jazari-akuna/lib-elec/3D/Board/NodeMCU Esp32/Src/esp32_dev_kit_v1_asm.stp

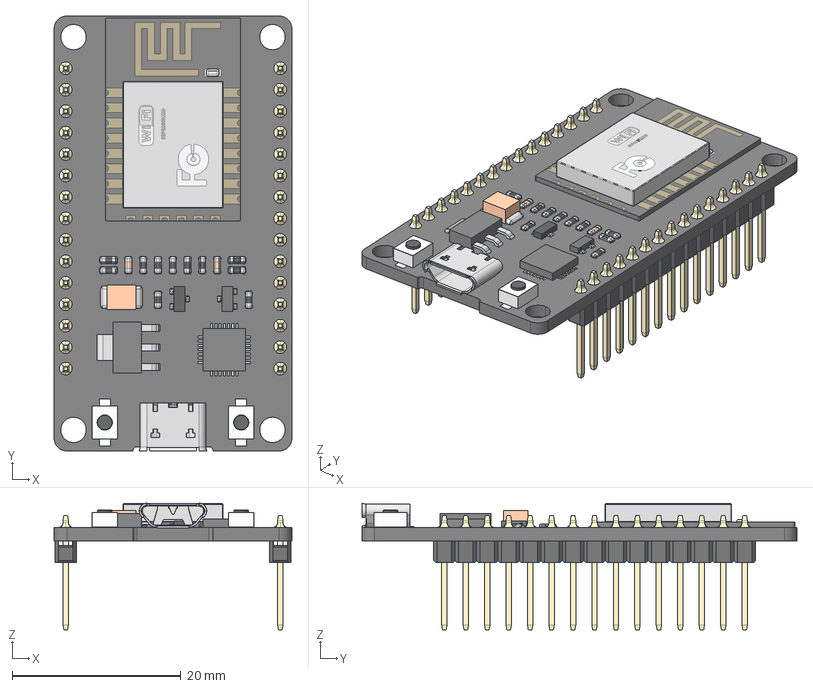
[picture p1: CAD file, 2024-03-29]
3D/Board/NodeMCU Esp32/Src/esp32_dev_kit_v1_asm.stp
28.1 x 51.5 x 15.0 mm
PCB
PIN x 30
WIFI_CARD_2
RECTANGULARCHIP_2
MICROCHIP_2
TANCHIP_2
TRANSISTOR_3-LEG_2
RESISTOR1_2 x 11
RESISTOR2-32_2 x 2
TRANSISTOR_3-LEG2_2
BUTTONFLASH-13_2 x 2
BUTTONFLASH-14_2 x 2
USB_SOCKET_2
