jazari-akuna/lib-elec/3D/Board/Adafruit BMP390/Adafruit BMP390 THT.stp

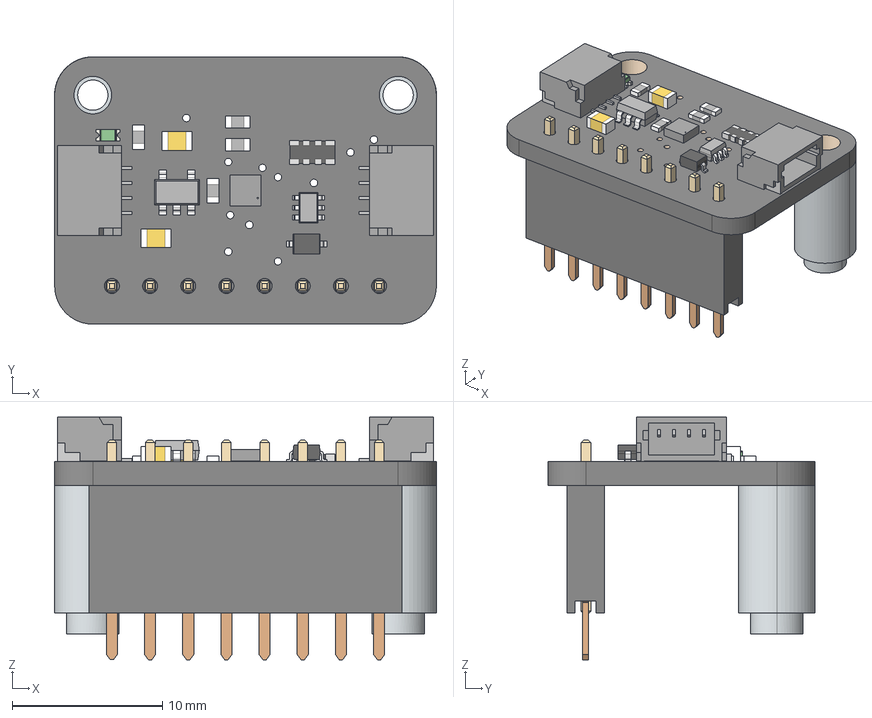
[picture p2: CAD file, 2024-08-19]
3D/Board/Adafruit BMP390/Adafruit BMP390 THT.stp
25.4 x 17.8 x 16.1 mm
Board
10K x 4
1N4148
BMP388
10uF x 2
AP2112K-3.3
10K_1
BSS138
STEMMA_I2C_QT x 2
GREEN
6130xx11821_PIN x 8
