jazari-akuna/lib-elec/3D/Board/Adafruit BNO085/Adafruit BNO085 with SMD Spacers.stp

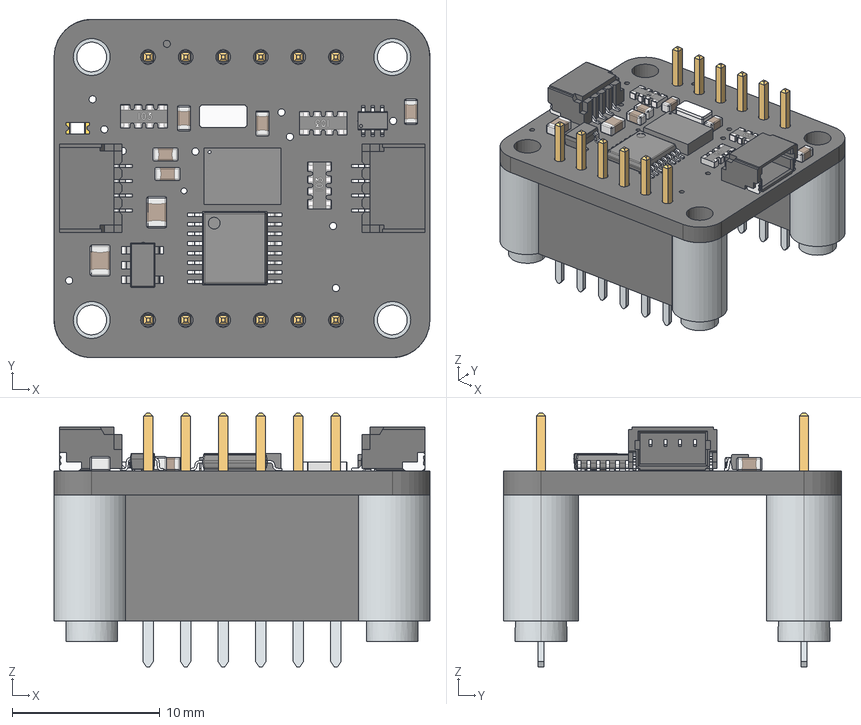
[picture p3: CAD file, 2024-08-19]
3D/Board/Adafruit BNO085/Adafruit BNO085 with SMD Spacers.stp
25.4 x 22.9 x 17.1 mm
Printed Circuit Board
BNO085-9axis-IMU
BODY-TSSOP
LEAD-TSSOP x 16
Crystal_XTAL3215_32.768KHz
SOT23-5
BSS138PS
LED 0603 single color
CAPC-0805-T0.95-BN x 2
CAPC-0603-T0.9-BN x 5
YC164_RESPACK x 3
qwicc x 2
6130xx11121_PIN x 12
6130xx11821_PIN x 12
