jazari-akuna/lib-elec/3D/Board/Adafruit BNO085/Src/Adafruit BNO085 STEMMA QT.step

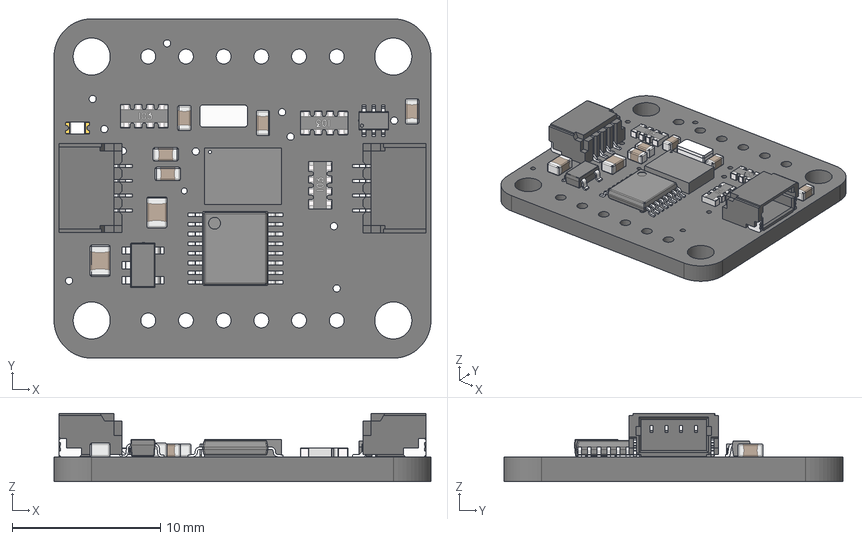
[picture p4: CAD file, 2023-10-14]
3D/Board/Adafruit BNO085/Src/Adafruit BNO085 STEMMA QT.step
25.4 x 22.9 x 4.60 mm
Printed Circuit Board
BNO055-9axis-IMU
BNO085-9axis-IMU
BODY-TSSOP
LEAD-TSSOP x 16
Crystal_XTAL3215_32.768KHz
SOT23-5
BSS138PS
LED 0603 single color
CAPC-0805-T0.95-BN x 2
CAPC-0603-T0.9-BN x 5
YC164_RESPACK x 3
qwicc x 2
