jazari-akuna/lib-elec/3D/Board/Adafruit SD Breakout/Adafruit SD Breakout.stp

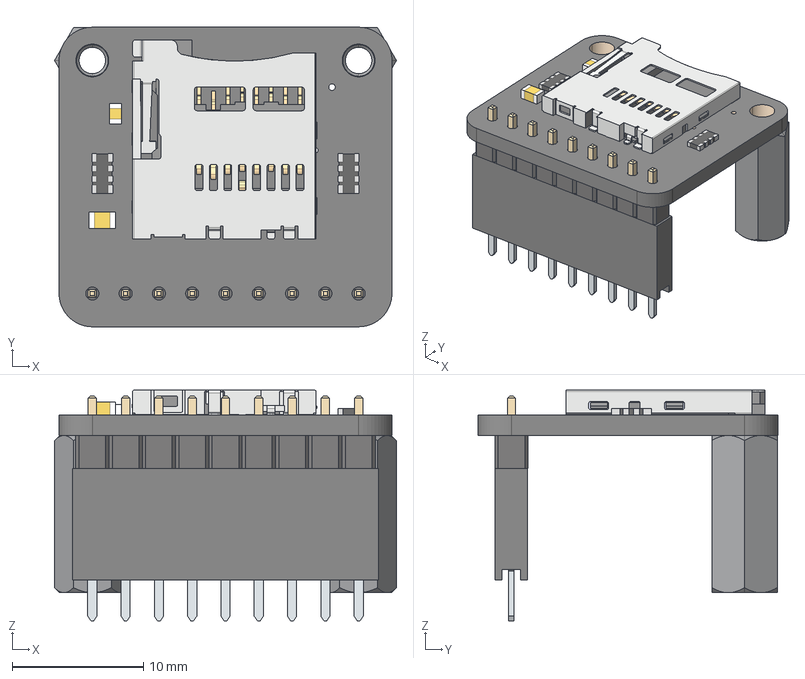
[picture p5: CAD file, 2024-08-19]
3D/Board/Adafruit SD Breakout/Adafruit SD Breakout.stp
26.1 x 22.9 x 17.6 mm
Board.1
microSD
10uF.3
0.1uF
47K x 2
6130xx11821_PIN x 9
