jazari-akuna/lib-elec/3D/Board/Arduino NanoV3 + Female Headers.step

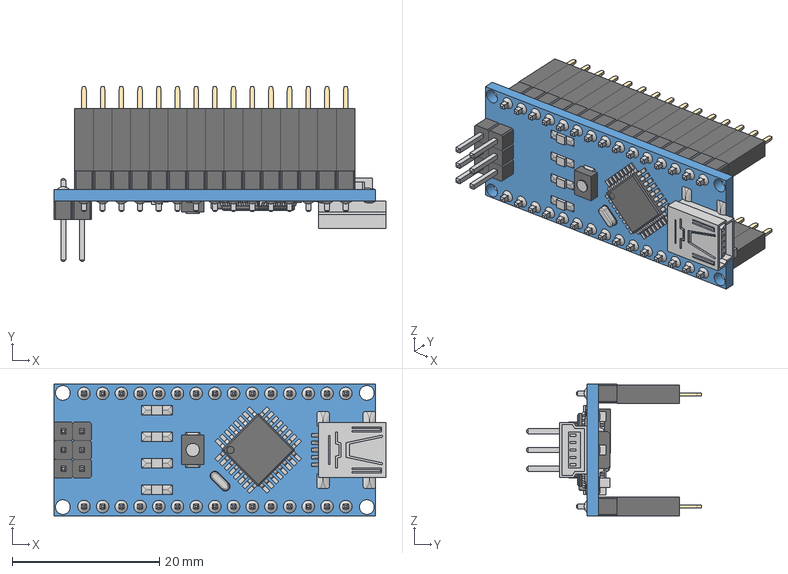
[picture p6: CAD file, 2022-04-12]
3D/Board/Arduino NanoV3 + Female Headers.step
45.1 x 23.7 x 17.9 mm
switch
Led x 3
Led (1)
Pin x 21
chip1
USB
Crystal
Pin (1) x 15
Res x 5
cap x 2
Chip
respack x 2
diode
vreg
HF1 x 30
