jazari-akuna/lib-elec/3D/Board/NodeMCU Esp32/NodeMCU Esp32.stp

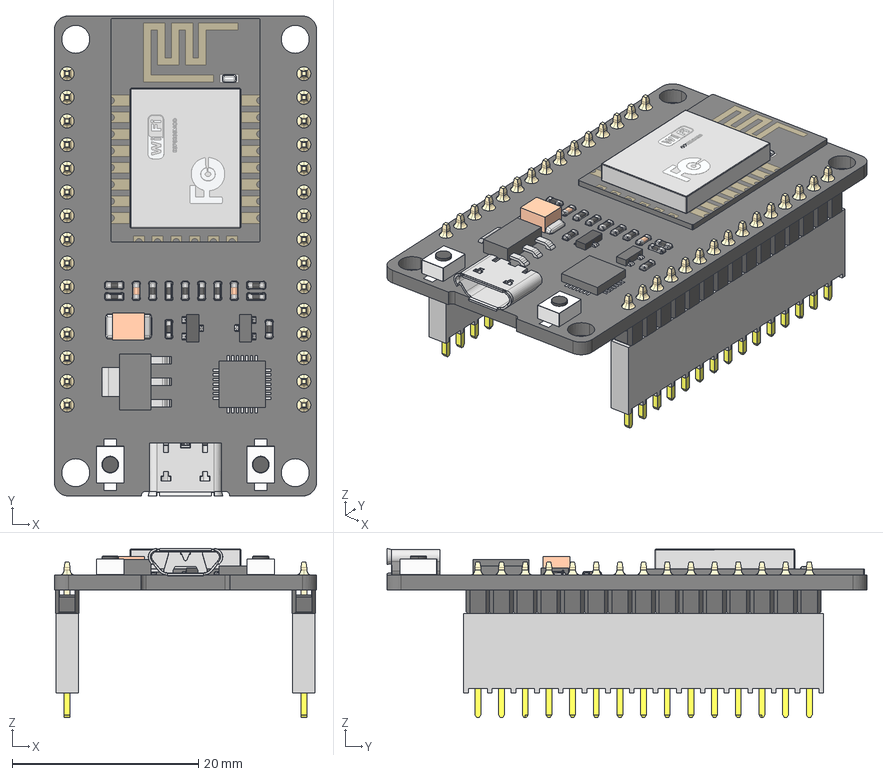
[picture p7: CAD file, 2024-03-29]
3D/Board/NodeMCU Esp32/NodeMCU Esp32.stp
28.1 x 51.5 x 18.2 mm
PCB
PIN x 30
WIFI_CARD_2
RECTANGULARCHIP_2
MICROCHIP_2
TANCHIP_2
TRANSISTOR_3-LEG_2
RESISTOR1_2 x 11
RESISTOR2-32_2 x 2
TRANSISTOR_3-LEG2_2
BUTTONFLASH-13_2 x 2
BUTTONFLASH-14_2 x 2
USB_SOCKET_2
_T1SSQ-115-01-G-S x 2
_P2SSQ-115-01-G-S x 2
