jazari-akuna/lib-elec/3D/Board/Nucleo F411RE/Src/Download_STEP_970110155 (rev1).stp

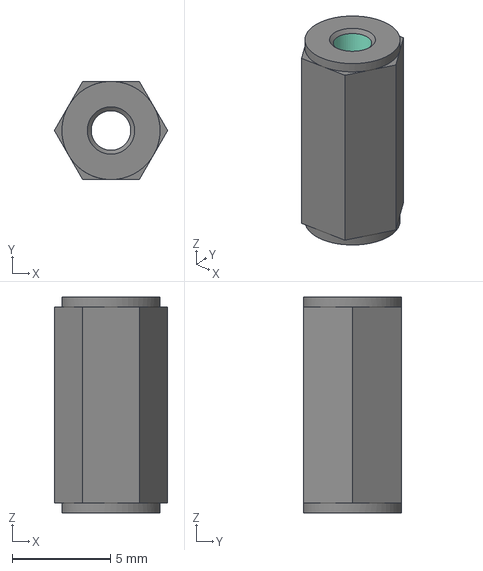
[picture p9: CAD file, 2021-08-15]
3D/Board/Nucleo F411RE/Src/Download_STEP_970110155 (rev1).stp
5.77 x 5.00 x 11.0 mm
