jazari-akuna/lib-elec/3D/Board/Nucleo F411RE/Src/Pin Header 2 x 19 2.54mm/38-Pin Header - Female - Double - 2.54mm.step

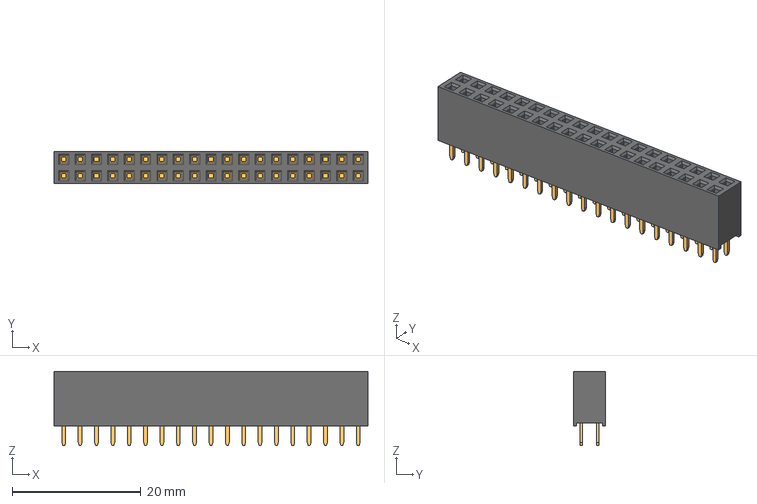
[picture p10: CAD file, 2021-11-29]
3D/Board/Nucleo F411RE/Src/Pin Header 2 x 19 2.54mm/38-Pin Header - Female - Double - 2.54mm.step
48.8 x 5.00 x 11.5 mm
