jazari-akuna/lib-elec/3D/Board/Raspberry Pi 4b/Src/Download_STEP_970180155 (rev1).stp

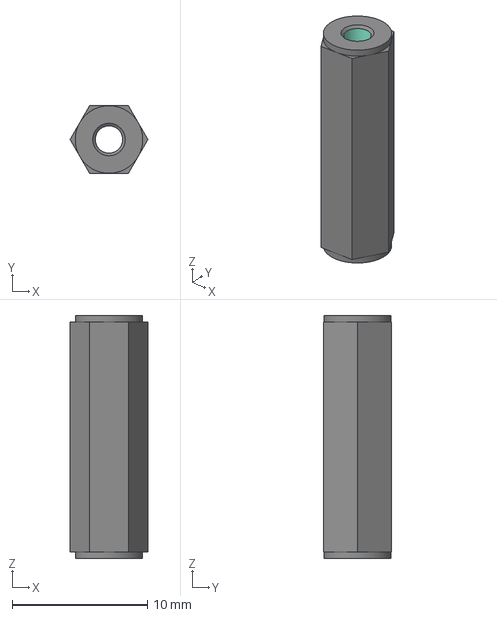
[picture p11: CAD file, 2021-08-15]
3D/Board/Raspberry Pi 4b/Src/Download_STEP_970180155 (rev1).stp
5.77 x 5.00 x 18.0 mm
