jazari-akuna/lib-elec/3D/Board/Raspberry Pi 4b/Src/ESQ-120-24-T-D/ESQ-120-24-T-D.stp

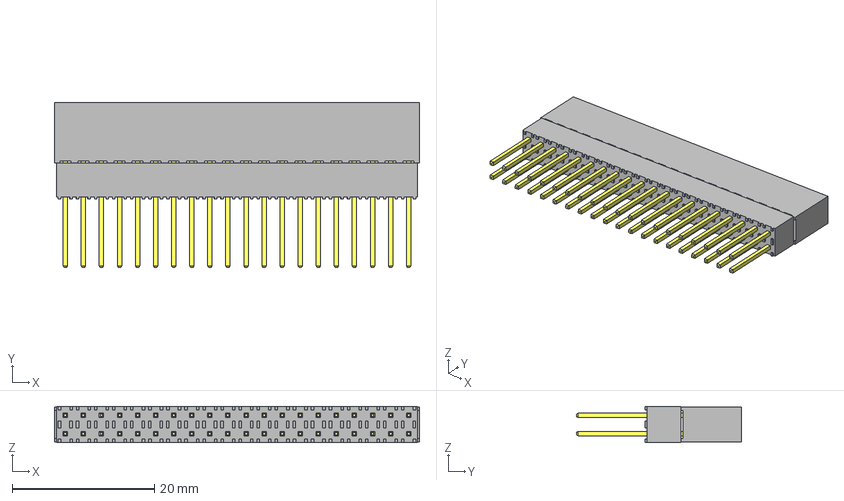
[picture p12: CAD file, 2021-01-02]
3D/Board/Raspberry Pi 4b/Src/ESQ-120-24-T-D/ESQ-120-24-T-D.stp
51.3 x 23.2 x 5.08 mm
_ESQ-120-24-T-D_socket
_ESQ-120-24-T-D_pins
_ESQ-120-24-G-D-LL_bpins
