jazari-akuna/lib-elec/3D/Board/Raspberry Pi Zero W/Src/microsd-card.stp

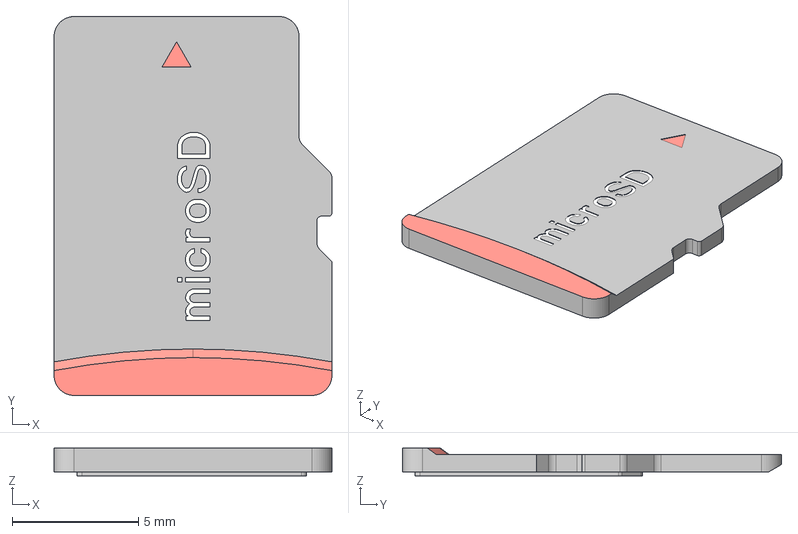
[picture p13: CAD file, 2024-03-23]
3D/Board/Raspberry Pi Zero W/Src/microsd-card.stp
11.0 x 15.0 x 1.10 mm
