jazari-akuna/lib-elec/3D/Components/Download_STEP_150302xx73100 (rev1).stp

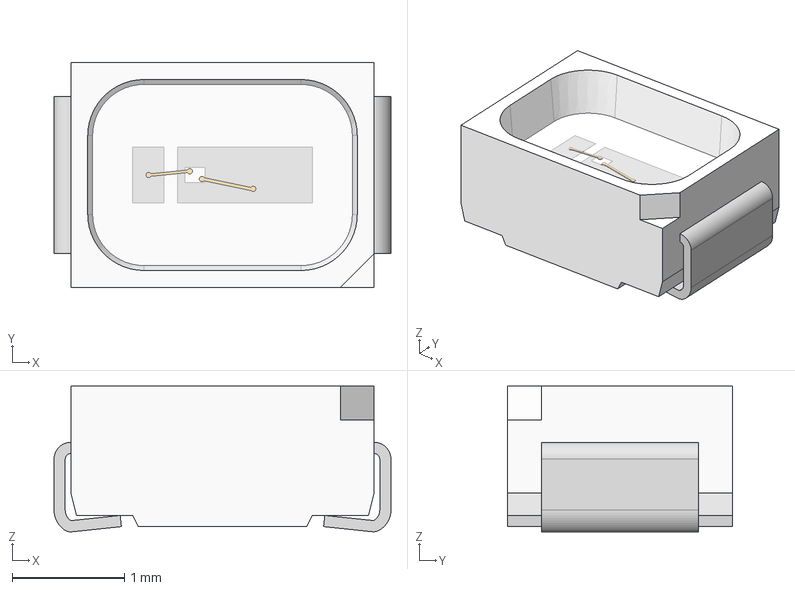
[picture p14: CAD file, 2025-03-05]
3D/Components/Download_STEP_150302xx73100 (rev1).stp
3.00 x 2.00 x 1.30 mm
Glue
Pin
