jazari-akuna/lib-elec/3D/Components/ESC/Download_STP_61300611121 (rev1).stp

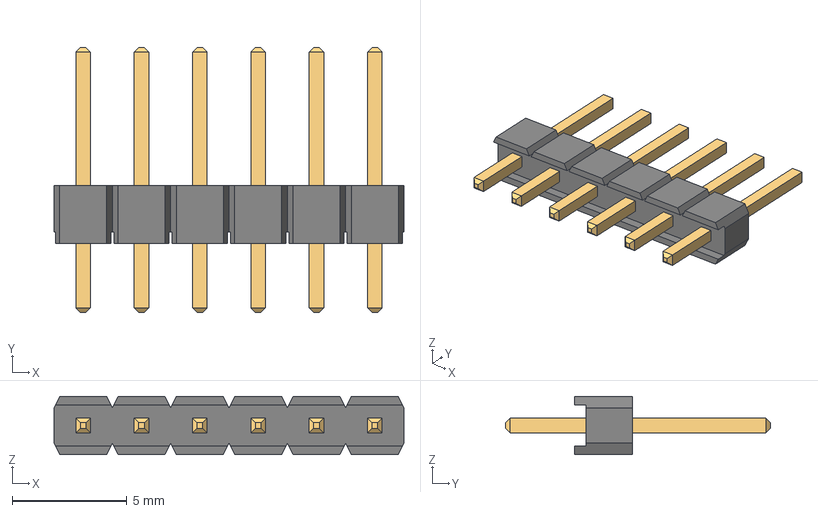
[picture p15: CAD file, 2023-07-14]
3D/Components/ESC/Download_STP_61300611121 (rev1).stp
15.2 x 11.5 x 2.54 mm
6130xx11121_PIN x 6
