jazari-akuna/lib-elec/3D/Components/MP1584EN/Download_STP_61300211121 (rev1).stp

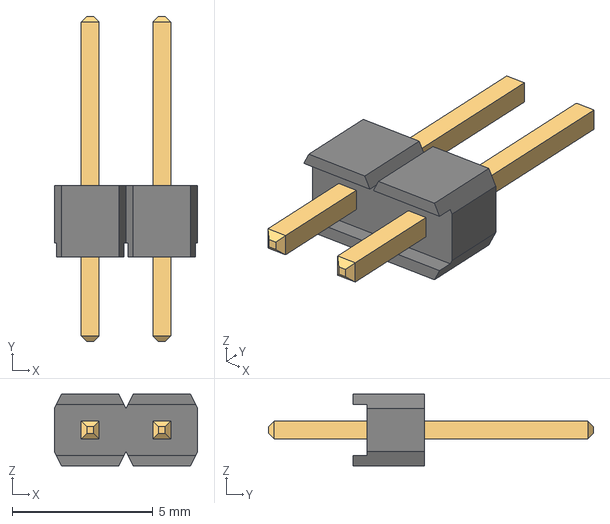
[picture p16: CAD file, 2022-04-12]
3D/Components/MP1584EN/Download_STP_61300211121 (rev1).stp
5.08 x 11.5 x 2.54 mm
6130xx11121_PIN x 2
