jazari-akuna/lib-elec/3D/Connectors/Download_STP_686108188622 (rev1).stp

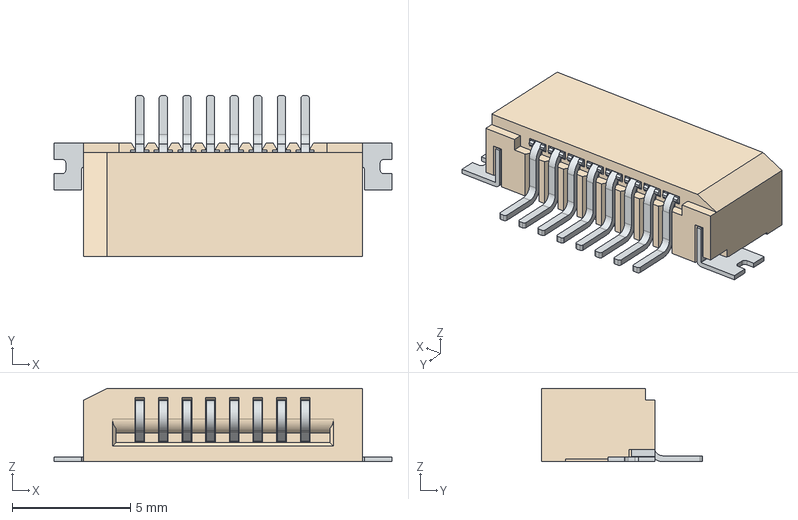
[picture p17: CAD file, 2025-01-11]
3D/Connectors/Download_STP_686108188622 (rev1).stp
14.3 x 6.80 x 3.11 mm
6861xx188622_Pin x 8
6861xx188622_PadGh
6861xx188622_PadDt
