jazari-akuna/lib-elec/3D/Pad Silicone 6x2mm.stp

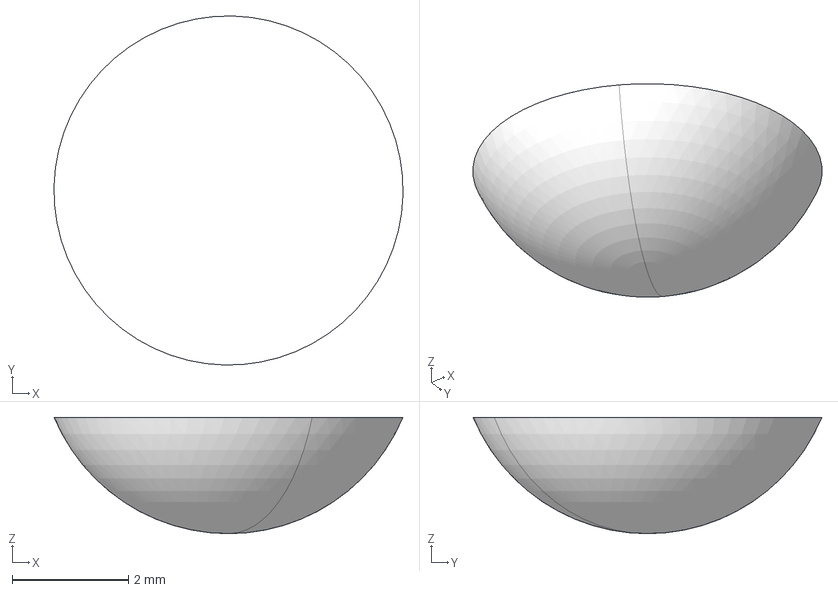
[picture p18: CAD file, 2023-09-23]
3D/Pad Silicone 6x2mm.stp
6.00 x 6.00 x 2.00 mm
