jazari-akuna/lib-elec/3D/Board/Nucleo F303K8/MB1180-with-connector.stp

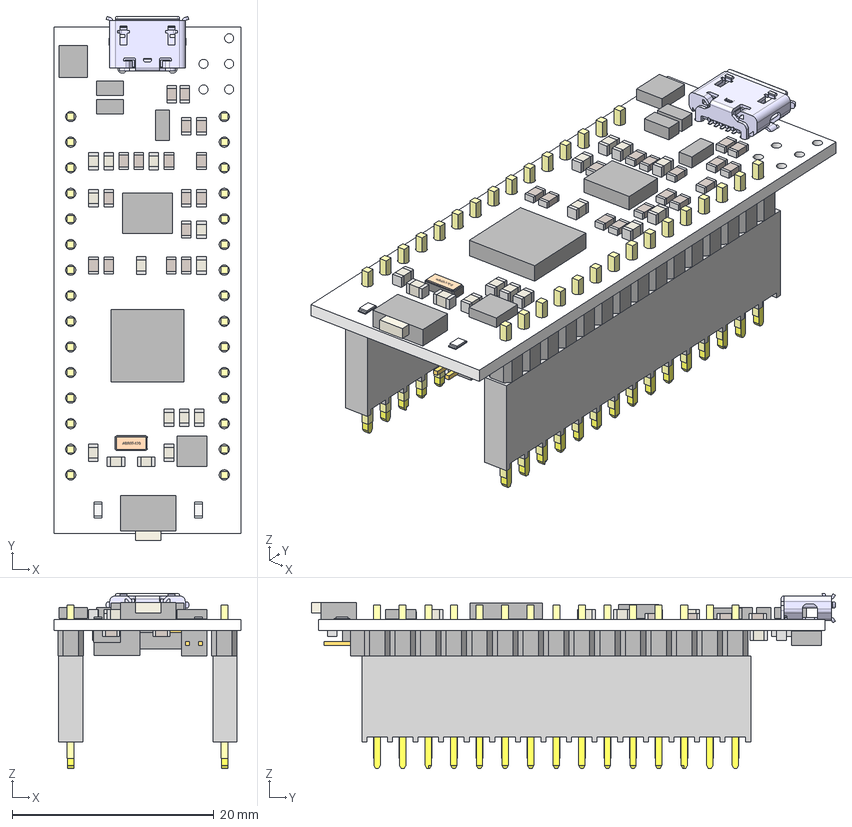
[picture p20: CAD file, 2020-11-15]
3D/Board/Nucleo F303K8/MB1180-with-connector.stp
18.5 x 52.0 x 17.4 mm
Extruded x 2
Extruded_1
Extruded_2
Extruded_3
Extruded_4 x 2
Extruded_5
Extruded_6
Extruded_7
Extruded_8 x 40
Extruded_9 x 20
Extruded_10 x 2
Extruded_11
ABS07-120
Extruded_12
Extruded_13
Extruded_14
Extruded_15
Extruded_16 x 34
Extruded_17 x 17
Extruded_18 x 12
Extruded_19 x 6
Extruded_20 x 2
Extruded_21
Extruded_22 x 2
Extruded_23
Extruded_24
Extruded_25
Extruded_26 x 2
Extruded_27 x 2
Extruded_28
Extruded_29 x 6
Extruded_30 x 3
Extruded_31 x 30
Extruded_32 x 30
Extruded_33
Extruded_34
Extruded_35
Extruded_36
_T1SSQ-115-01-G-S x 2
_P2SSQ-115-01-G-S x 2
