jazari-akuna/lib-elec/3D/Components/ESC/CtrlBL_Emax_Bullet_Pro_35A.STEP

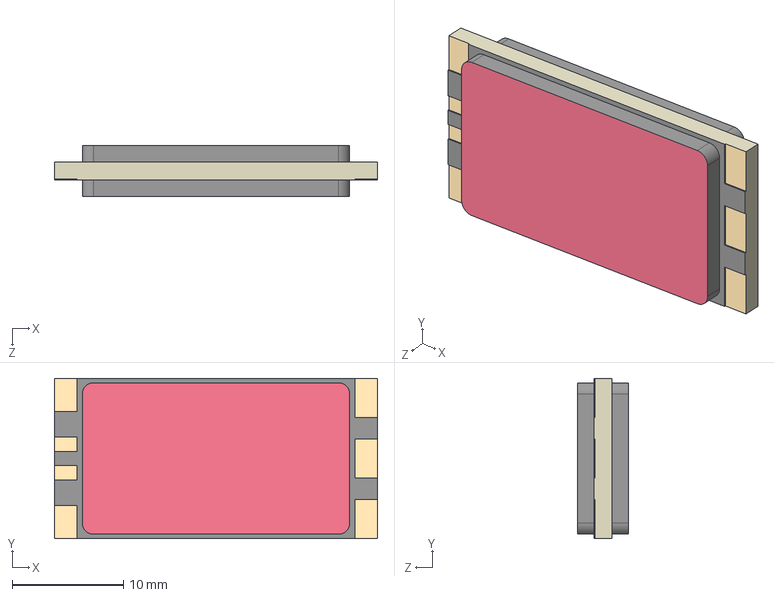
[picture p22: CAD file, 2023-07-14]
3D/Components/ESC/CtrlBL_Emax_Bullet_Pro_35A.STEP
29.0 x 14.4 x 4.60 mm
