jazari-akuna/lib-elec/3D/Components/GC9A01/GC9A01.stp

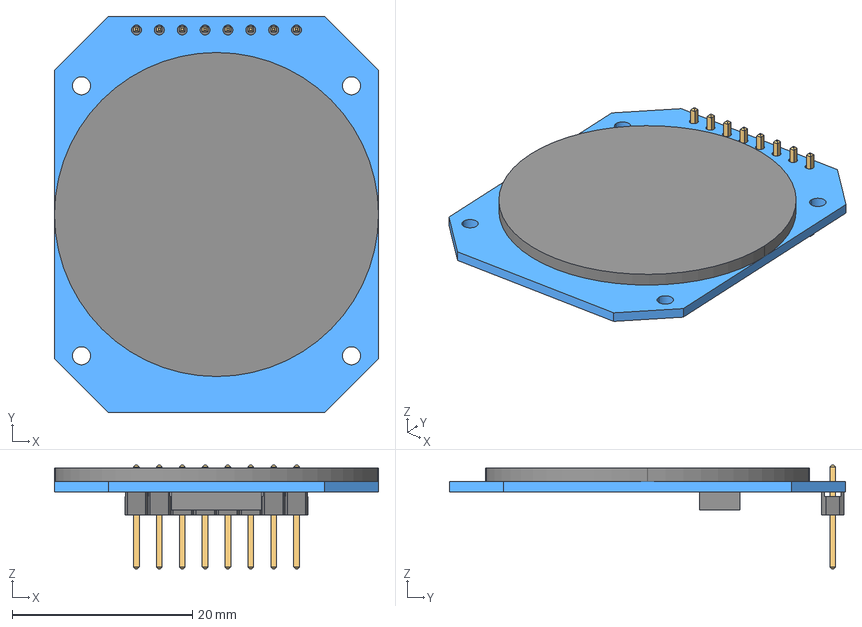
[picture p23: CAD file, 2023-07-14]
3D/Components/GC9A01/GC9A01.stp
36.0 x 44.0 x 11.5 mm
GC9A01.1
6130xx11121_PIN x 8
