jazari-akuna/lib-elec/3D/Components/KS33-low profile switch and stabilzier.stp

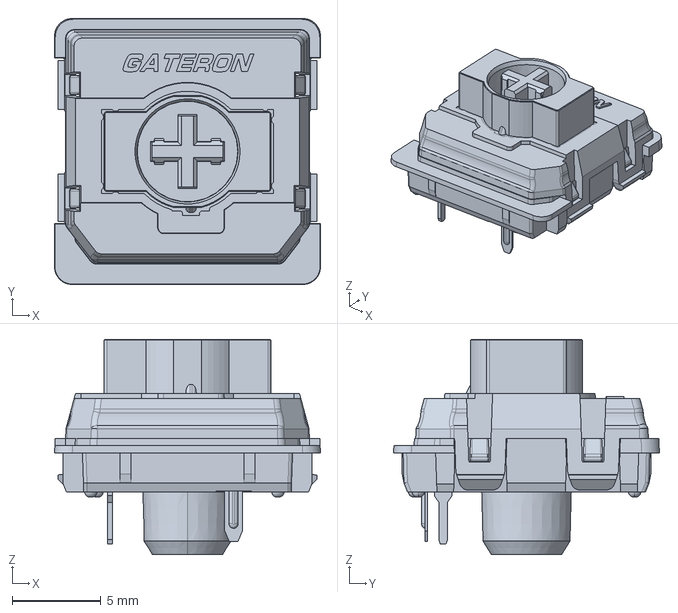
[picture p24: CAD file, 2025-03-05]
3D/Components/KS33-low profile switch and stabilzier.stp
15.0 x 15.0 x 12.1 mm
