jazari-akuna/lib-elec/3D/Connectors/Download_STEP_693071020811 (rev1).stp

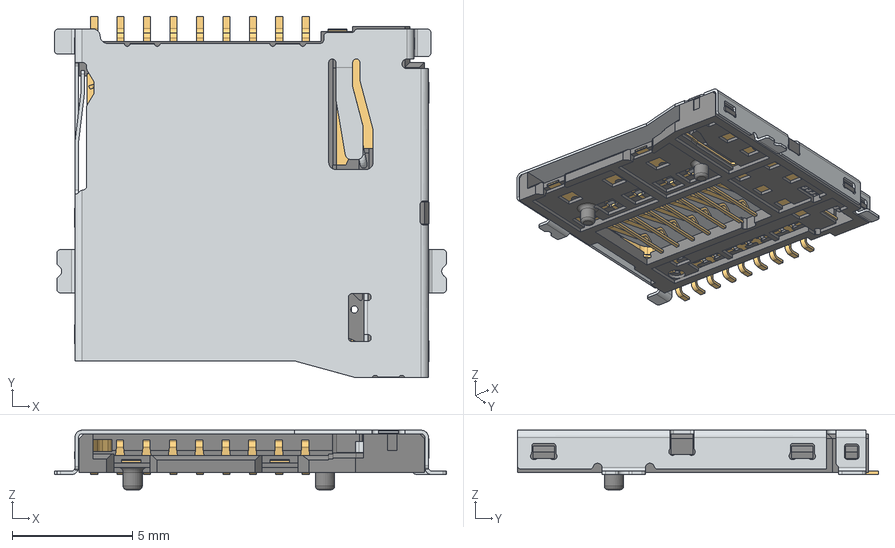
[picture p25: CAD file, 2024-11-05]
3D/Connectors/Download_STEP_693071020811 (rev1).stp
16.3 x 15.0 x 2.48 mm
693071020811_Housing
693071020811_Guide
693071020811_Spring
693071020811_Contact
693071020811_Hook
693071020811_Agraphe
693071020811_Shielding
