jazari-akuna/lib-elec/3D/Board/Nucleo F303K8/Src/SSQ-115-01-G-S.stp

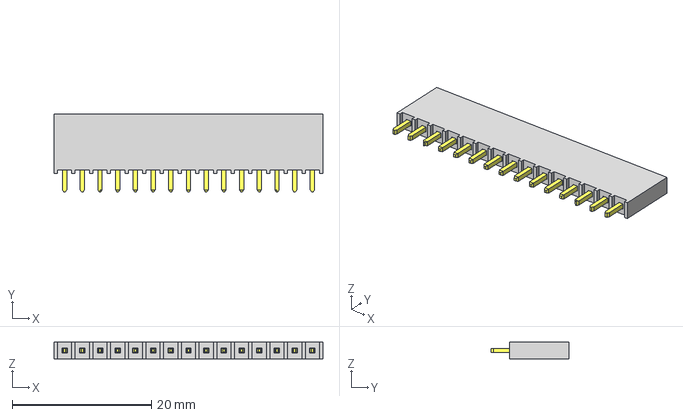
[picture p26: CAD file, 2020-11-15]
3D/Board/Nucleo F303K8/Src/SSQ-115-01-G-S.stp
38.6 x 11.2 x 2.41 mm
_T1SSQ-115-01-G-S
_P2SSQ-115-01-G-S
