jazari-akuna/lib-elec/3D/Components/Download_STP_830009678 (rev1).stp

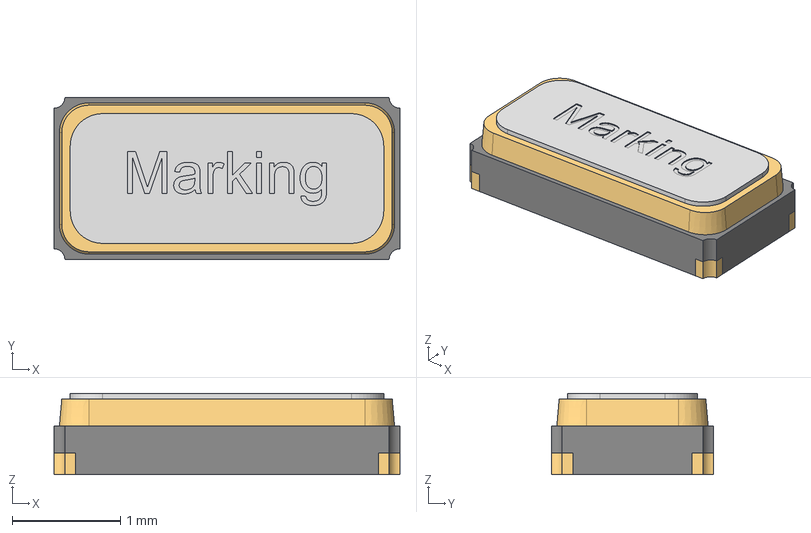
[picture p27: CAD file, 2025-02-01]
3D/Components/Download_STP_830009678 (rev1).stp
3.20 x 1.50 x 0.75 mm
Pins
Cover
