jazari-akuna/lib-elec/3D/Components/ESC/ESC_Emax_Bullet_15A.stp

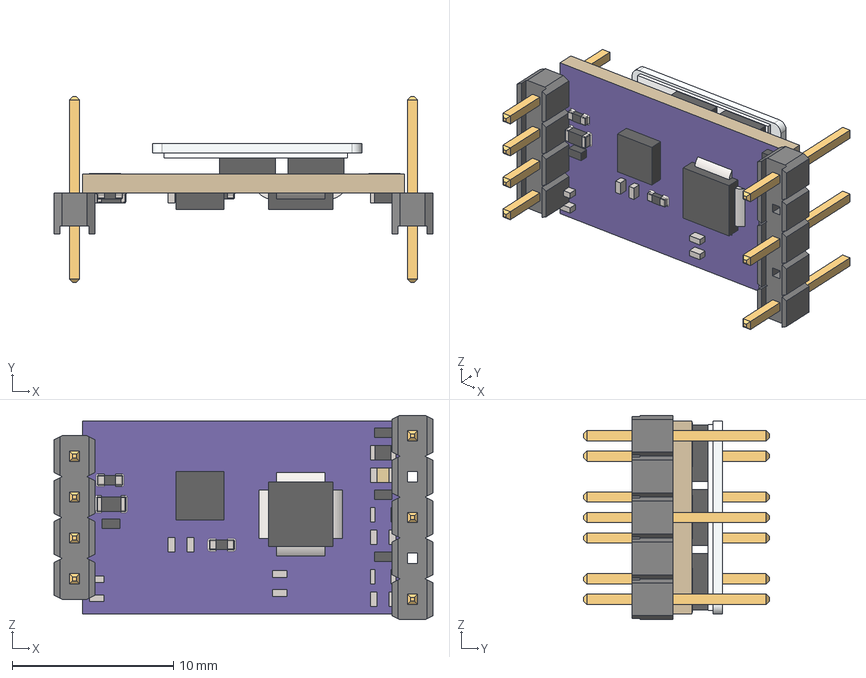
[picture p28: CAD file, 2023-07-14]
3D/Components/ESC/ESC_Emax_Bullet_15A.stp
23.5 x 11.5 x 12.7 mm
CtrlBL_Emax_Bullet_15A_light
6130xx11121_PIN x 4
6130xx11121_PIN.2 x 3
