jazari-akuna/lib-elec/3D/Components/GC9A01/GC9A01-LowProfile.stp

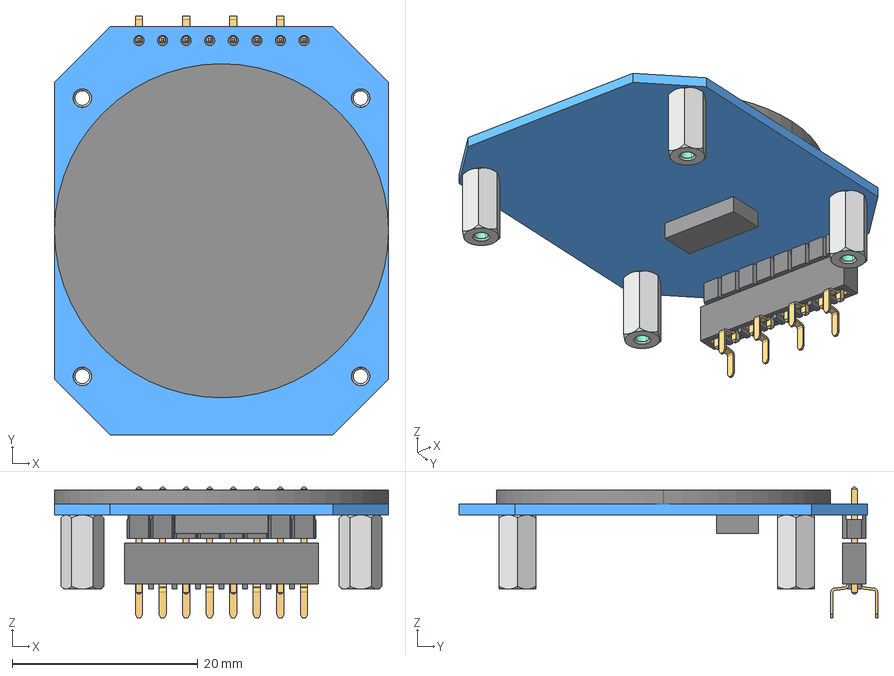
[picture p29: CAD file, 2023-07-14]
3D/Components/GC9A01/GC9A01-LowProfile.stp
36.0 x 45.1 x 14.1 mm
GC9A01.1
6130xx11121_PIN x 8
6130xx15721_PIN x 8
