jazari-akuna/lib-elec/3D/Components/Downloads_STP_WL-OSEN_1642730961200 (rev1).stp

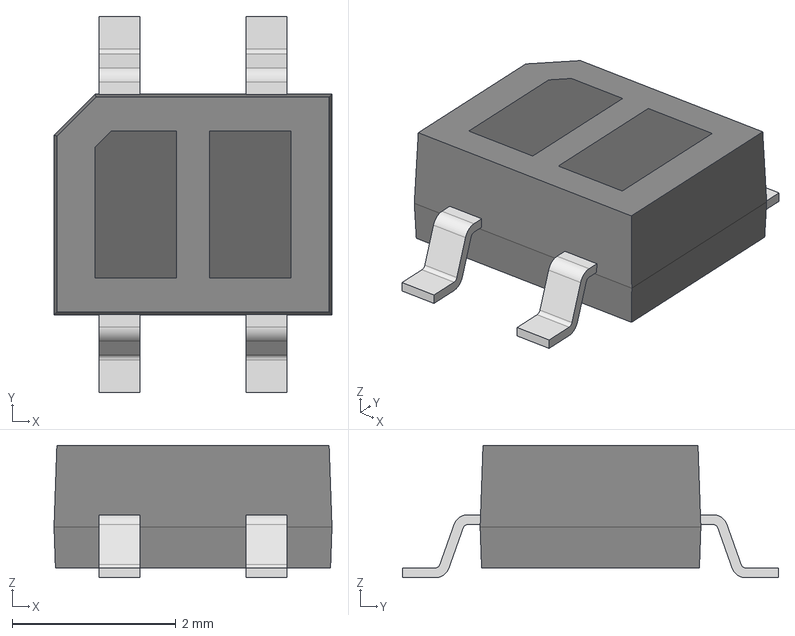
[picture p30: CAD file, 2025-01-11]
3D/Components/Downloads_STP_WL-OSEN_1642730961200 (rev1).stp
3.40 x 4.60 x 1.62 mm
Dome
Pins
