jazari-akuna/lib-elec/3D/Components/ESC/CtrlBL_Emax_Bullet_15A_light.STEP

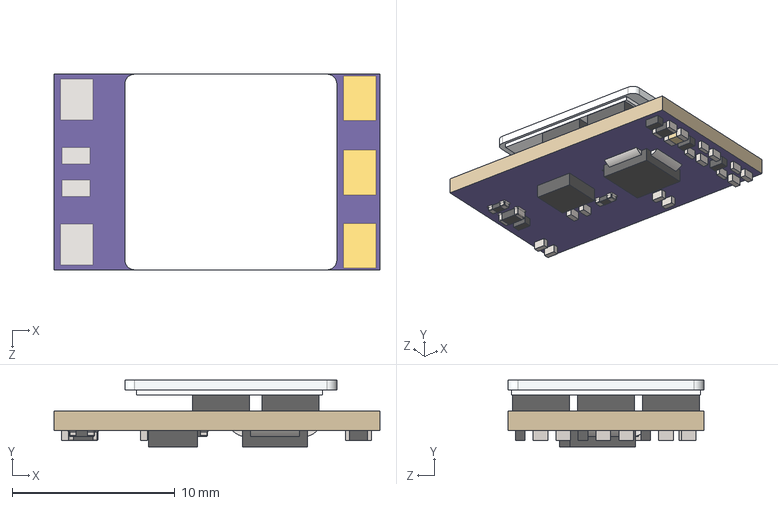
[picture p31: CAD file, 2023-07-14]
3D/Components/ESC/CtrlBL_Emax_Bullet_15A_light.STEP
20.0 x 4.10 x 12.0 mm
