jazari-akuna/lib-elec/3D/Components/GC9A01/Download_STEP_970080244 (rev1).stp

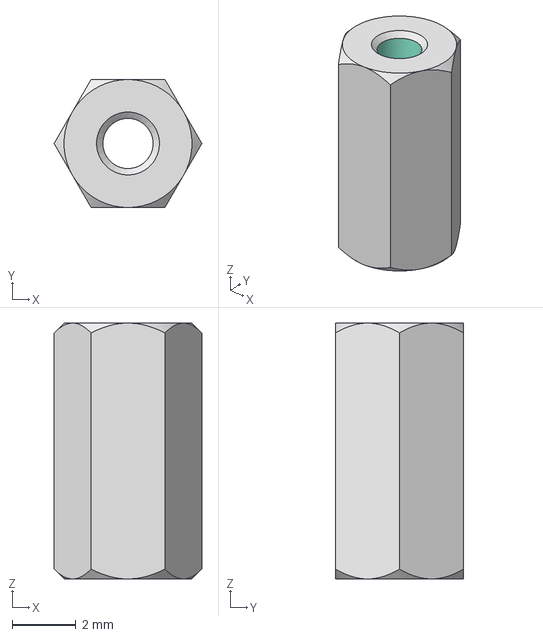
[picture p32: CAD file, 2023-07-14]
3D/Components/GC9A01/Download_STEP_970080244 (rev1).stp
4.62 x 4.00 x 8.00 mm
