jazari-akuna/lib-elec/3D/Connectors/RSP-122811-01--3DModel-STEP-56544.STEP

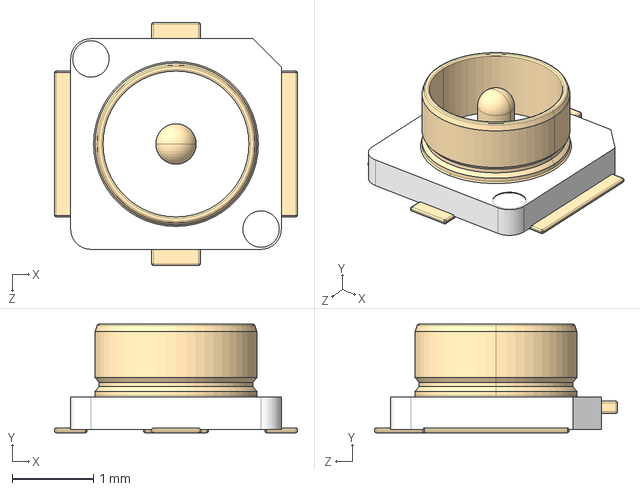
[picture p33: CAD file, 2024-10-28]
3D/Connectors/RSP-122811-01--3DModel-STEP-56544.STEP
3.00 x 1.34 x 3.00 mm
