jazari-akuna/lib-elec/3D/Components/BNO085.stp

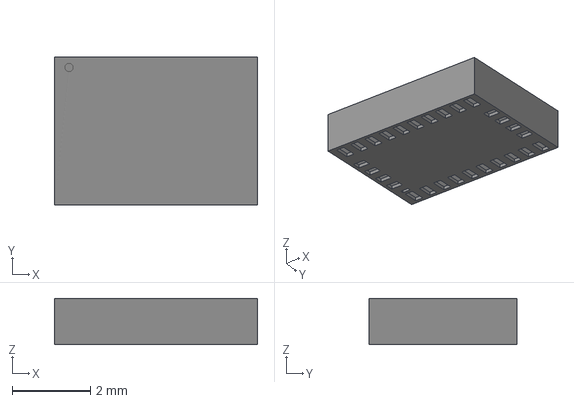
[picture p34: CAD file, 2025-01-02]
3D/Components/BNO085.stp
5.20 x 3.80 x 1.18 mm
