jazari-akuna/lib-elec/3D/Components/ESC/Download_STP_61300411121 (rev1).stp

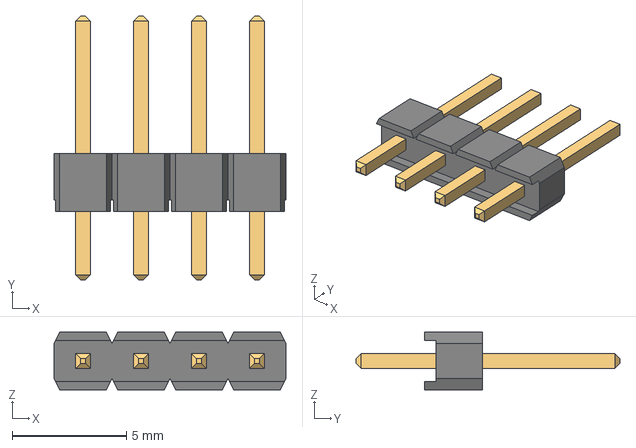
[picture p35: CAD file, 2023-07-14]
3D/Components/ESC/Download_STP_61300411121 (rev1).stp
10.2 x 11.5 x 2.54 mm
6130xx11121_PIN x 4
