jazari-akuna/lib-elec/3D/Connectors/Download_STP_62701420621_rev1.stp

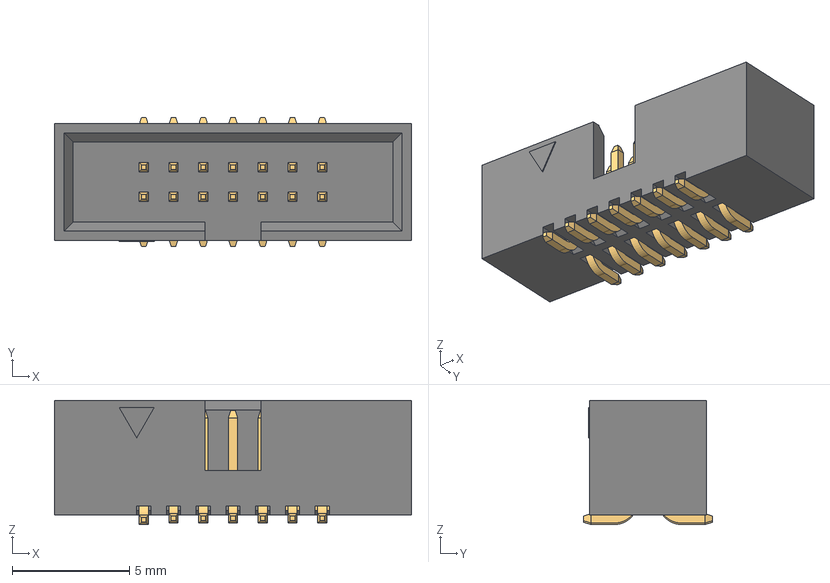
[picture p36: CAD file, 2024-10-28]
3D/Connectors/Download_STP_62701420621_rev1.stp
15.2 x 5.51 x 5.30 mm
6270xx20621_PIN x 14
