jazari-akuna/lib-elec/3D/Components/ESC/ESC_Emax_Bullet_35A.stp

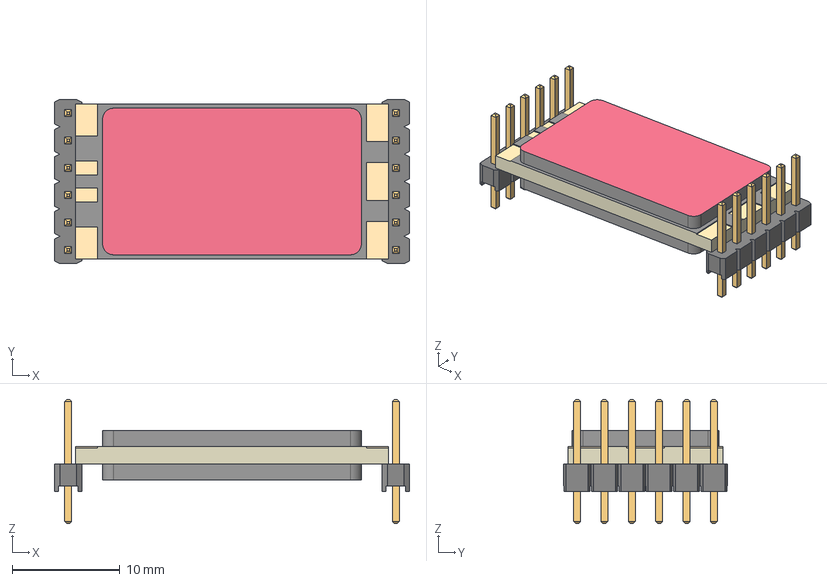
[picture p37: CAD file, 2023-07-14]
3D/Components/ESC/ESC_Emax_Bullet_35A.stp
32.9 x 15.2 x 11.5 mm
CtrlBL_Emax_Bullet_Pro_35A
6130xx11121_PIN x 6
6130xx11121_PIN.2 x 6
