jazari-akuna/lib-elec/3D/Components/PAA5160E1-Q-16L-6x6-LGA.stp

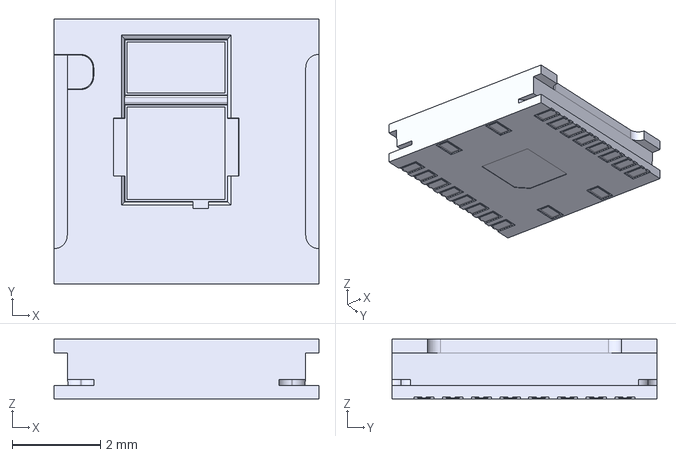
[picture p38: CAD file, 2025-01-02]
3D/Components/PAA5160E1-Q-16L-6x6-LGA.stp
6.00 x 6.00 x 1.35 mm
