jazari-akuna/lib-elec/3D/Components/Download_435441019830_STP (rev1).stp

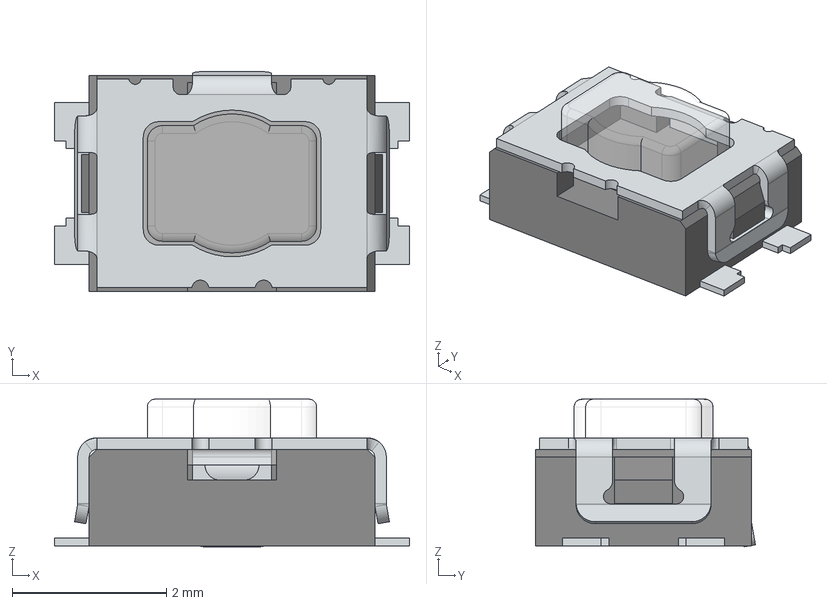
[picture p39: CAD file, 2024-11-05]
3D/Components/Download_435441019830_STP (rev1).stp
4.60 x 2.85 x 1.91 mm
Frame
Cover
Terminal
Button
