jazari-akuna/lib-elec/3D/Components/STP_WL-ICLED_1313210530000 (rev1).stp

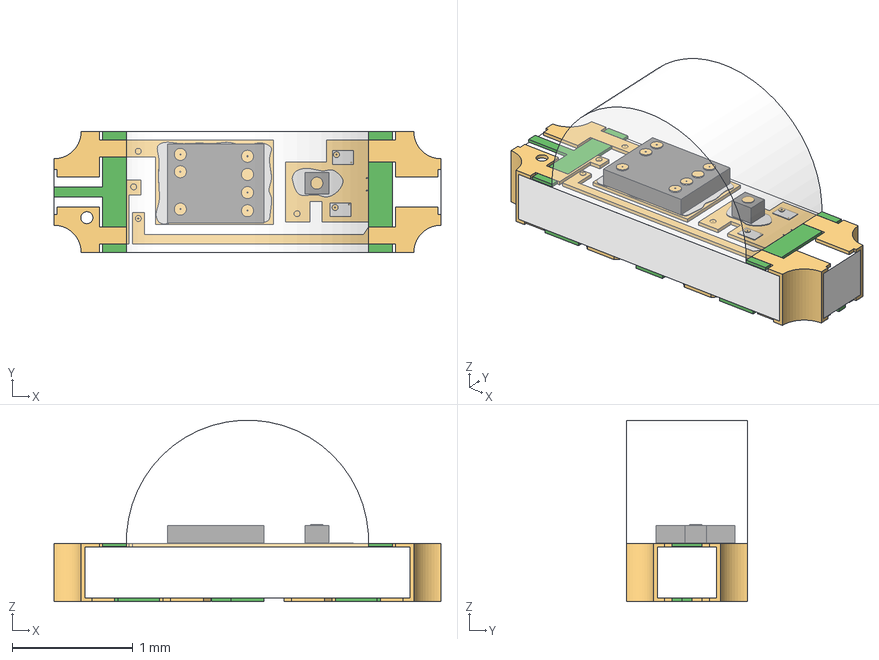
[picture p41: CAD file, 2024-11-05]
3D/Components/STP_WL-ICLED_1313210530000 (rev1).stp
3.20 x 1.00 x 1.50 mm
Contacts
Resin
