jazari-akuna/lib-elec/3D/Connectors/GCT_USB4140-GF-0170-C_REV0.4.stp

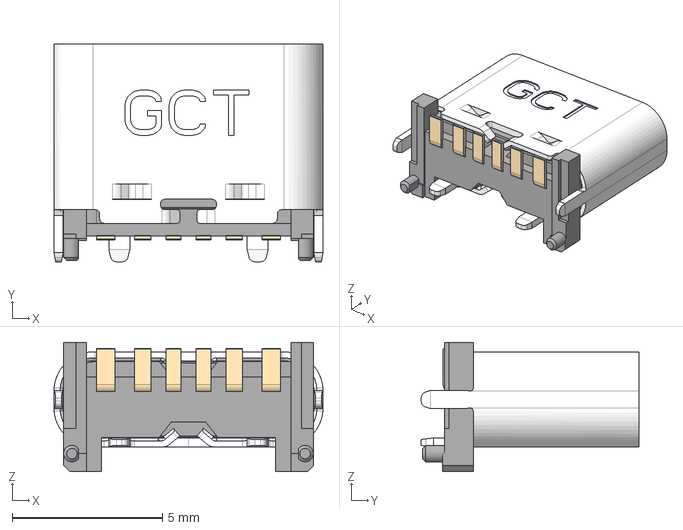
[picture p42: CAD file, 2024-01-22]
3D/Connectors/GCT_USB4140-GF-0170-C_REV0.4.stp
8.94 x 7.23 x 4.30 mm
USB4140-GF-0070-C_PART2
USB4140-GF-0070-C_PART1
