jazari-akuna/lib-elec/3D/Components/STP_74663025 (rev1).stp

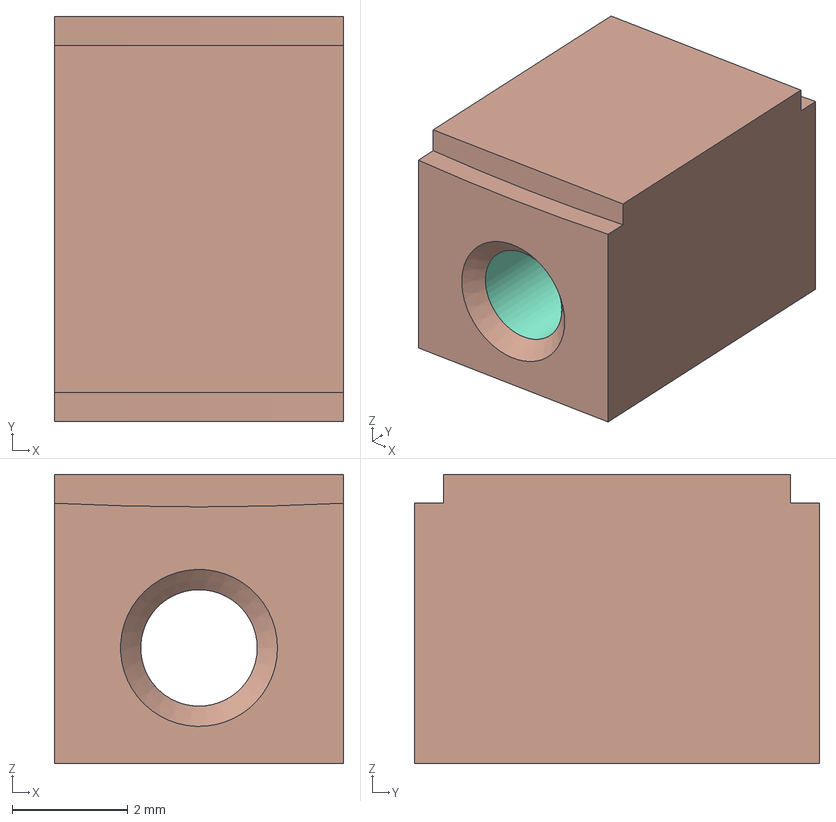
[picture p43: CAD file, 2024-03-09]
3D/Components/STP_74663025 (rev1).stp
5.00 x 7.00 x 5.00 mm
