jazari-akuna/lib-elec/3D/Connectors/STP_MPC5_657003140101 (rev1).stp

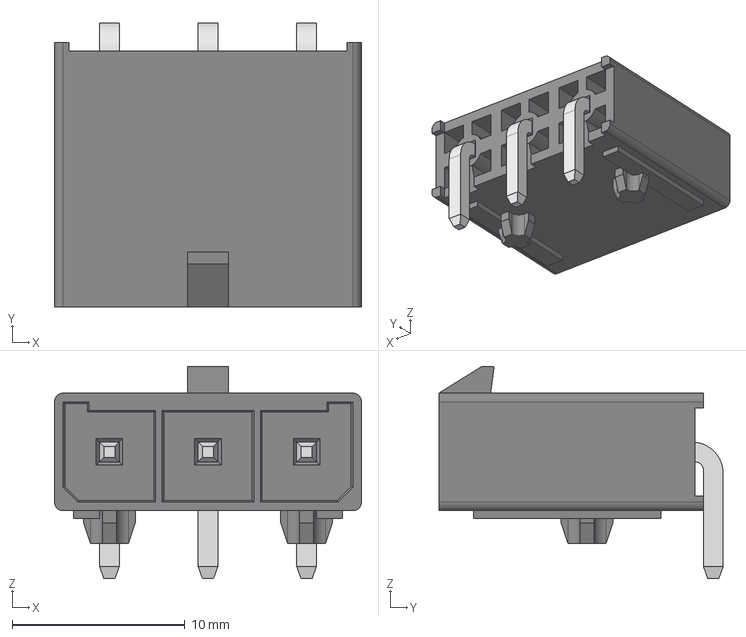
[picture p44: CAD file, 2023-11-17]
3D/Connectors/STP_MPC5_657003140101 (rev1).stp
17.8 x 16.4 x 12.3 mm
6570xx140101_Pin x 3
