jazari-akuna/lib-elec/3D/Connectors/STP_MPC5_657002140101 (rev1).stp

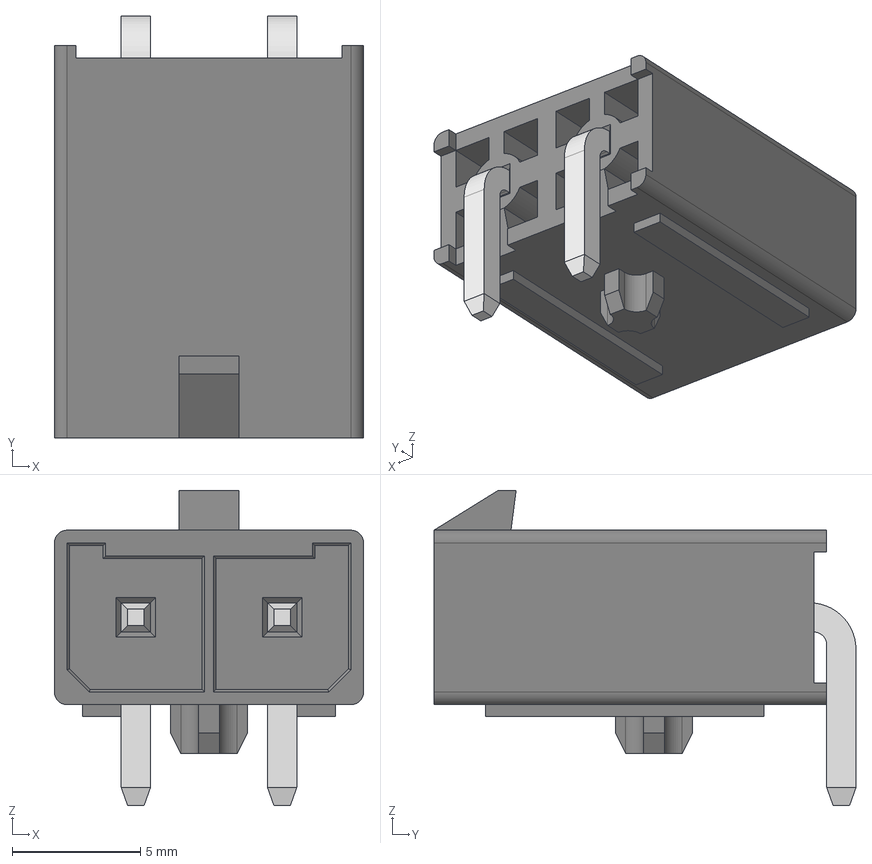
[picture p45: CAD file, 2023-11-17]
3D/Connectors/STP_MPC5_657002140101 (rev1).stp
12.1 x 16.4 x 12.3 mm
6570xx140101_Pin x 2
