jazari-akuna/lib-elec/3D/Components/Download_STP_WL-SBCW-1210 (rev1).stp

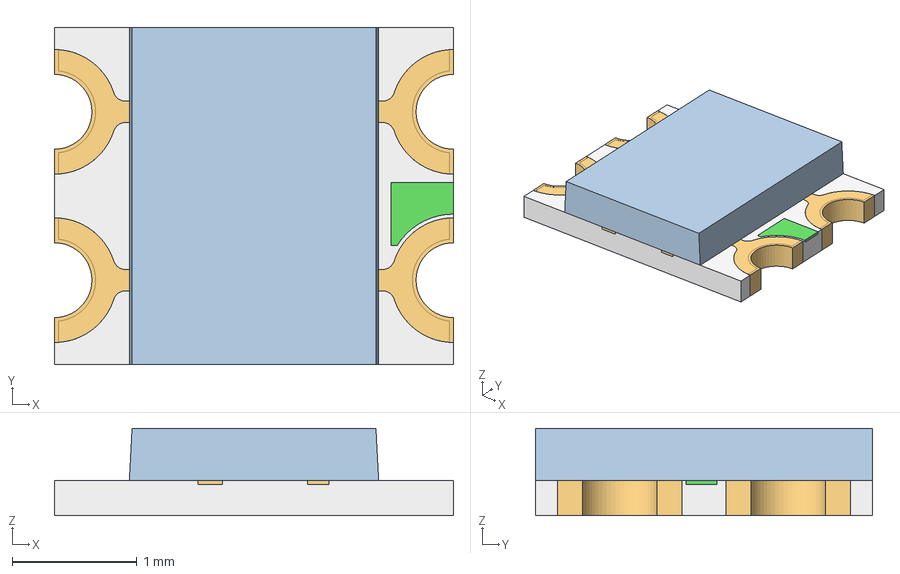
[picture p46: CAD file, 2023-12-19]
3D/Components/Download_STP_WL-SBCW-1210 (rev1).stp
3.20 x 2.70 x 0.7 mm
pole x 2
contact x 4
lense
