jazari-akuna/lib-elec/3D/Connectors/USB4125-GF-A_REVA2.step

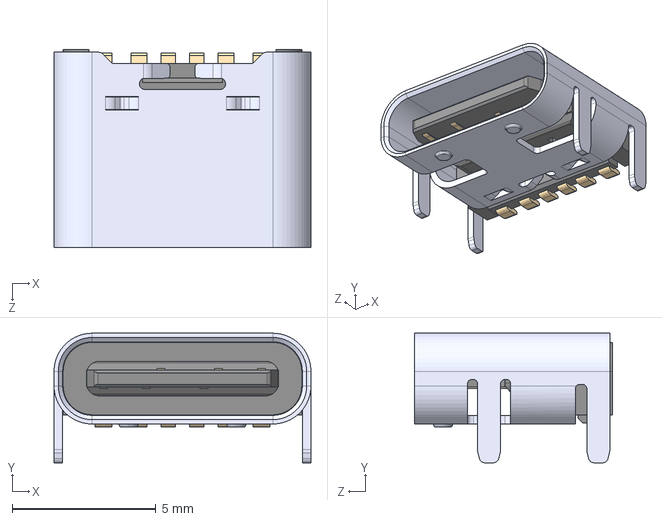
[picture p47: CAD file, 2023-10-15]
3D/Connectors/USB4125-GF-A_REVA2.step
8.94 x 4.51 x 6.90 mm
