jazari-akuna/lib-elec/3D/Components/Power Switch RS SPDT.stp

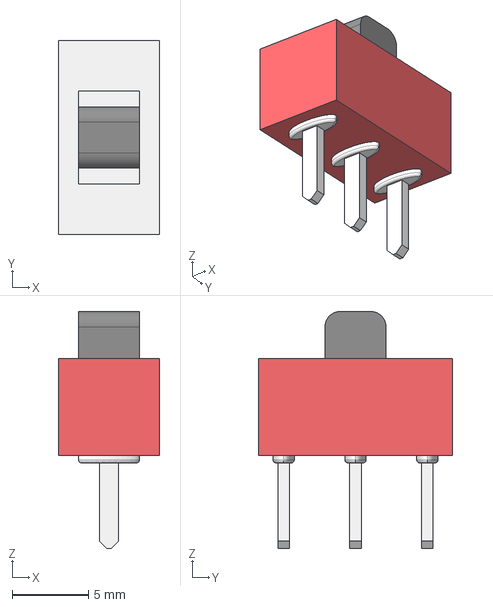
[picture p48: CAD file, 2023-11-02]
3D/Components/Power Switch RS SPDT.stp
6.60 x 12.7 x 15.5 mm
