jazari-akuna/lib-elec/3D/Connectors/SFW15R-1STE1LF.step

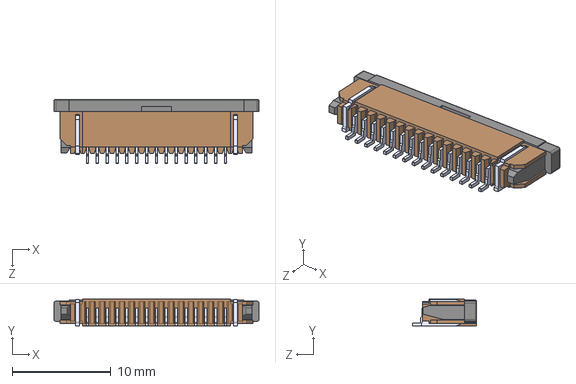
[picture p49: CAD file, 2023-09-20]
3D/Connectors/SFW15R-1STE1LF.step
20.8 x 2.70 x 6.50 mm
