jazari-akuna/lib-elec/3D/Components/Download_STP_WL-SMTW_3528_Dome-30 (rev1).stp

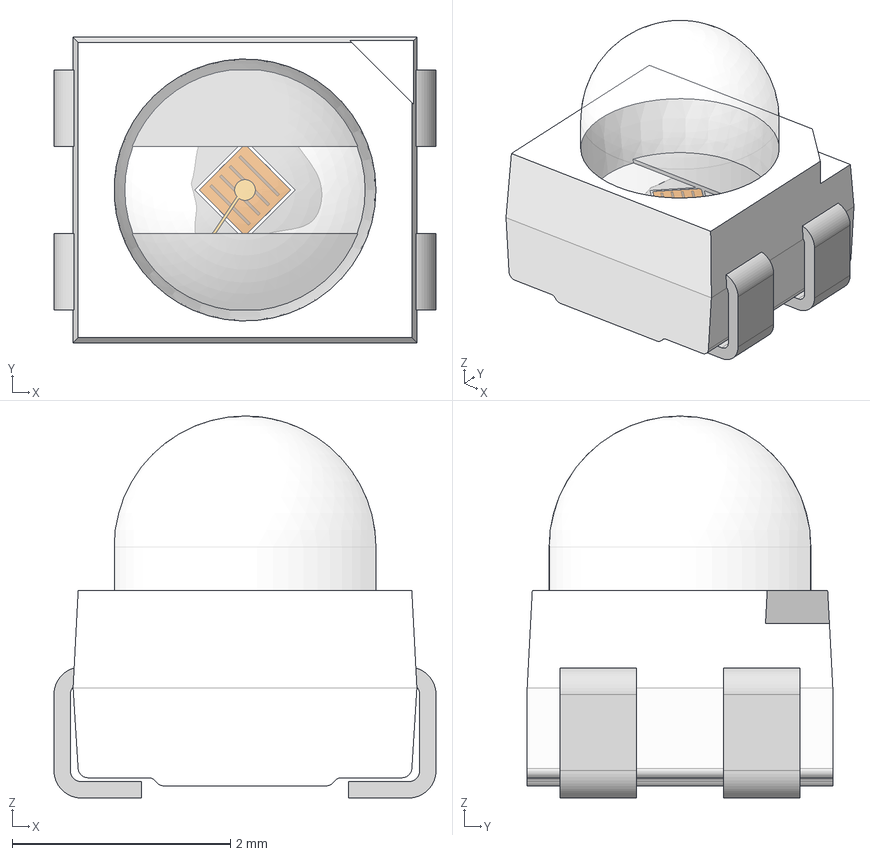
[picture p51: CAD file, 2023-10-15]
3D/Components/Download_STP_WL-SMTW_3528_Dome-30 (rev1).stp
3.50 x 2.80 x 3.50 mm
Pins
Dome
