jazari-akuna/lib-elec/3D/Components/tsr2_3d_drawing.stp

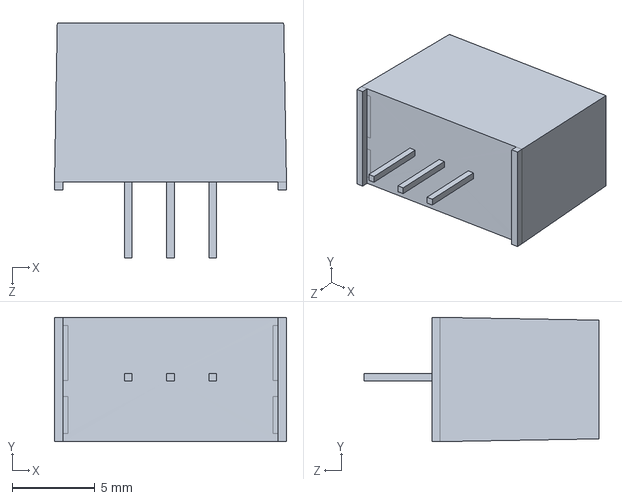
[picture p52: CAD file, 2023-10-05]
3D/Components/tsr2_3d_drawing.stp
14.0 x 7.50 x 14.2 mm
