jazari-akuna/lib-elec/3D/Connectors/Pogo connector 19 pins female.stp

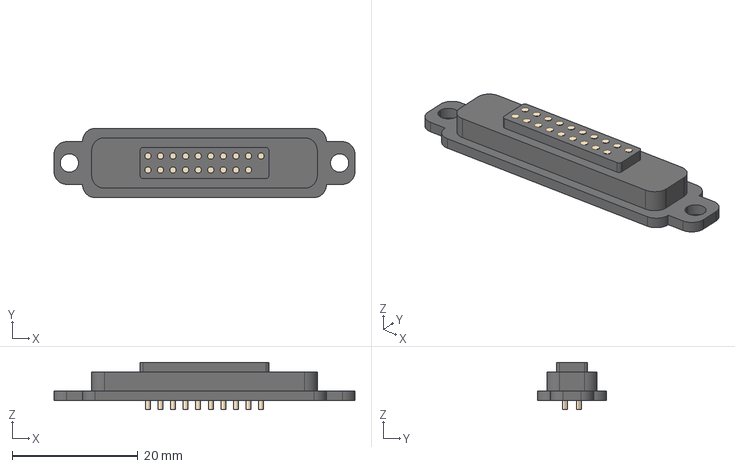
[picture p53: CAD file, 2023-08-05]
3D/Connectors/Pogo connector 19 pins female.stp
47.9 x 11.0 x 7.55 mm
