jazari-akuna/lib-elec/3D/Components/ADNS_9800_Lentille.stp

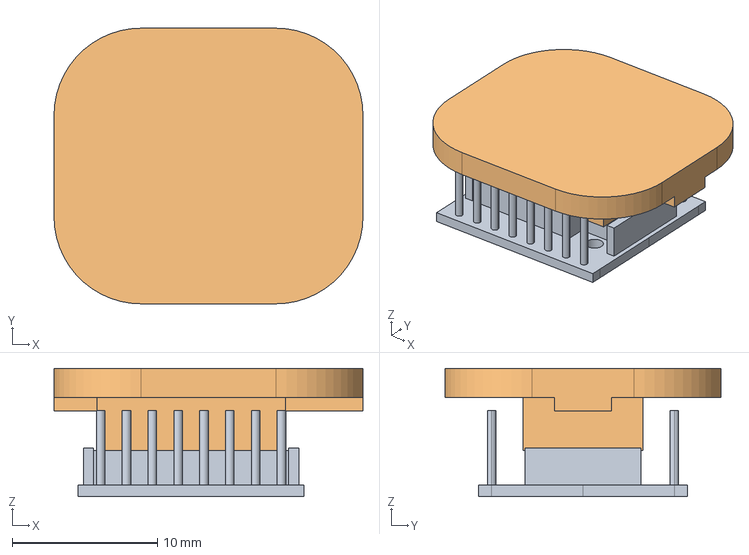
[picture p54: CAD file, 2023-09-23]
3D/Components/ADNS_9800_Lentille.stp
21.3 x 19.0 x 8.85 mm
