jazari-akuna/lib-elec/3D/Components/Buzzer 9x5.stp

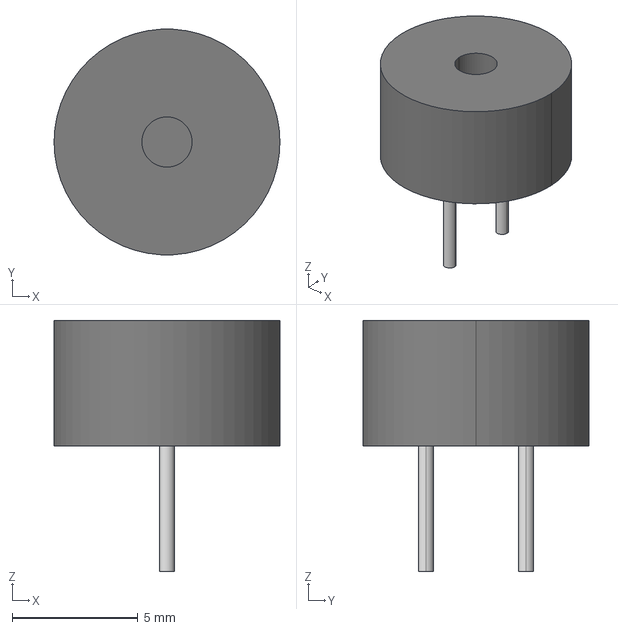
[picture p55: CAD file, 2023-09-23]
3D/Components/Buzzer 9x5.stp
9.00 x 8.98 x 10.0 mm
