jazari-akuna/lib-elec/3D/Connectors/Pogo connector 19 pins male.stp

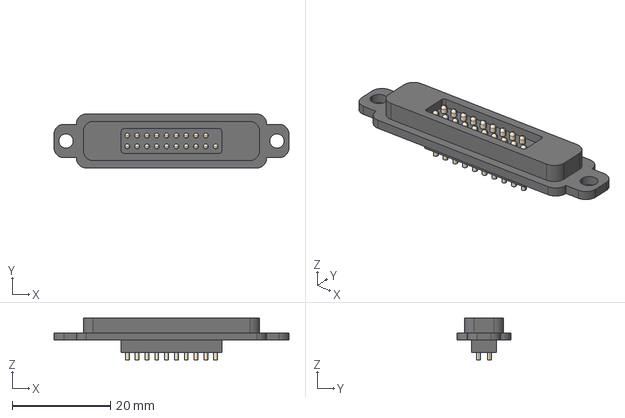
[picture p56: CAD file, 2023-08-05]
3D/Connectors/Pogo connector 19 pins male.stp
47.9 x 11.0 x 8.50 mm
