jazari-akuna/lib-elec/3D/Components/Download_STP_452404020202 (rev1).stp

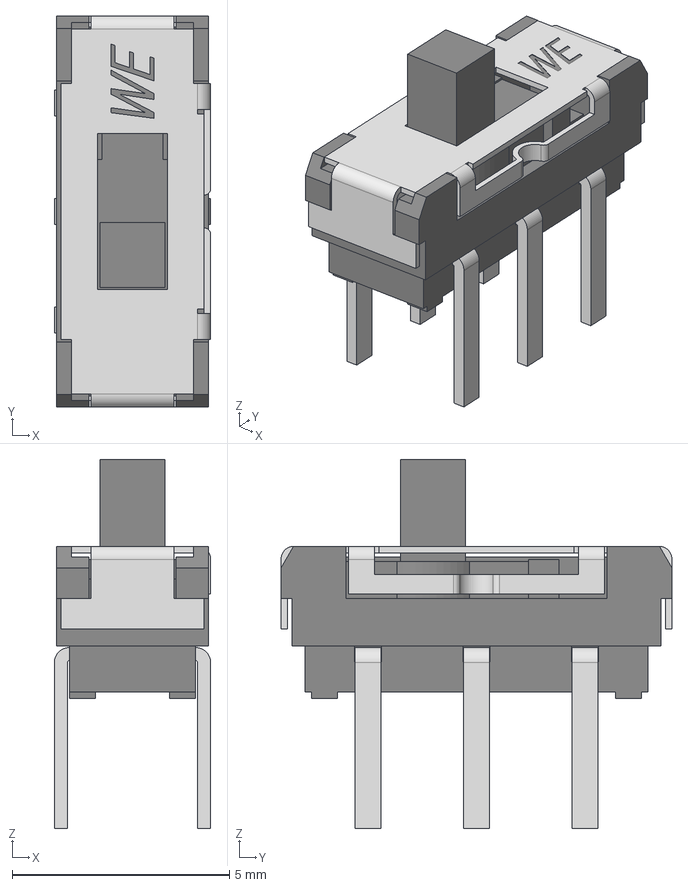
[picture p57: CAD file, 2023-09-02]
3D/Components/Download_STP_452404020202 (rev1).stp
3.60 x 9.00 x 8.50 mm
Terminal
Slider
Cover
