jazari-akuna/lib-elec/3D/Components/Download_STP_452403012014 (rev1).stp

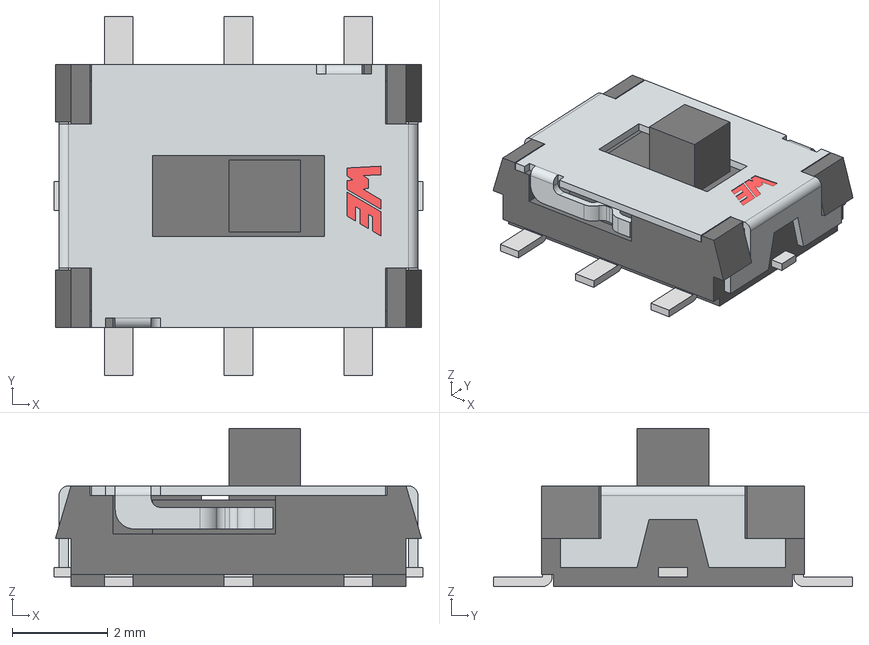
[picture p58: CAD file, 2023-09-01]
3D/Components/Download_STP_452403012014 (rev1).stp
7.70 x 7.50 x 3.30 mm
Base
Actuator
cover
