jazari-akuna/lib-elec/3D/Components/3557-2.step

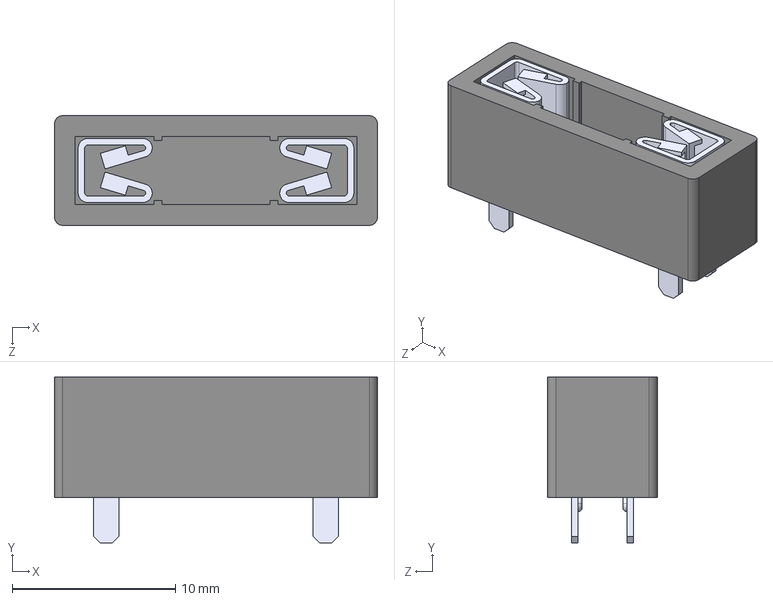
[picture p59: CAD file, 2023-08-05]
3D/Components/3557-2.step
19.8 x 10.2 x 6.73 mm
