jazari-akuna/lib-elec/3D/Components/wsen-pdus_STP_2513130810001 (rev1).stp

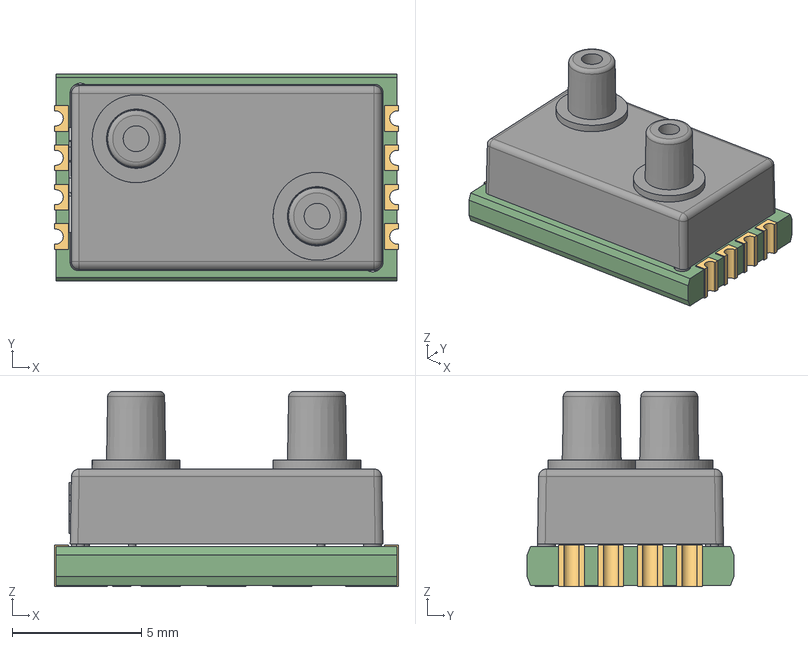
[picture p60: CAD file, 2023-08-05]
3D/Components/wsen-pdus_STP_2513130810001 (rev1).stp
13.3 x 8.00 x 7.55 mm
8k_cover_V-strt_2.step
WE_logo.step
hpsd8000_PCBfull
