jazari-akuna/lib-elec/3D/Components/PDC004-PD v4.step

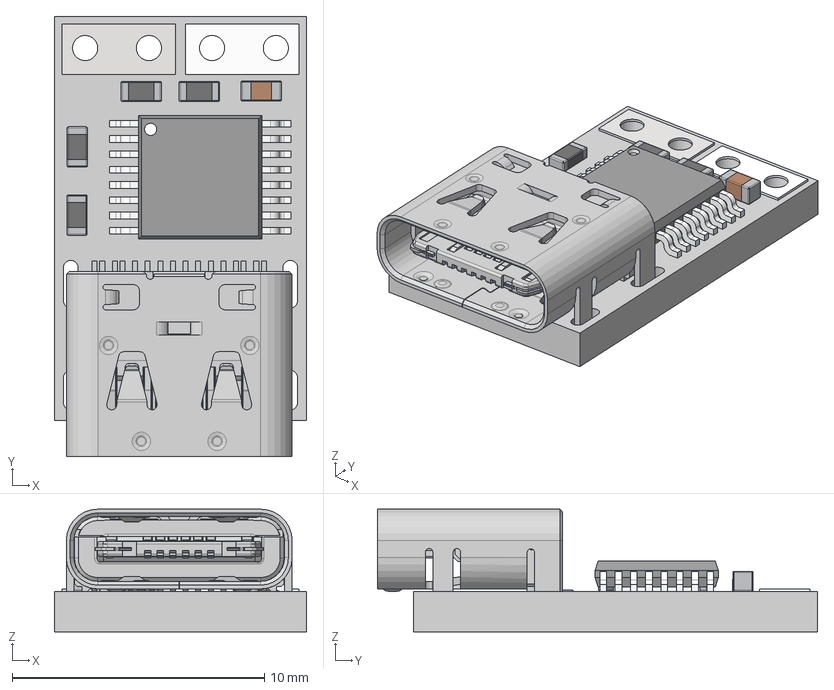
[picture p61: CAD file, 2023-07-14]
3D/Components/PDC004-PD v4.step
10.0 x 17.4 x 4.86 mm
USB - C v1
Pin10
Pin9
Pin12
Pin11
Pin13
Pin14
Pin15
Pin16
Pin8
Pin7
Pin6
Pin5
Pin4
Pin3
Pin2
Pin1
res_603 v1
res_603 v1 (1)
res_603 v1 (2)
res_603 v1 (3)
cap_603 v1
