jazari-akuna/lib-elec/3D/Connectors/Download_STP_65100516121 (rev1).stp

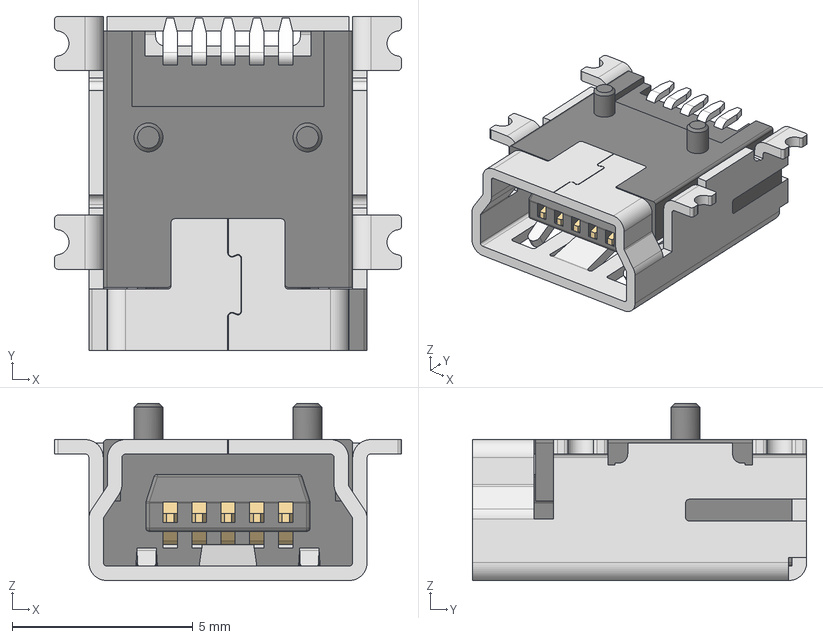
[picture p62: CAD file, 2023-01-10]
3D/Connectors/Download_STP_65100516121 (rev1).stp
9.60 x 9.25 x 4.90 mm
Shielding
Insulator
Pin_1 x 5
