jazari-akuna/lib-elec/3D/Components/STP_9774160360 (rev1).stp

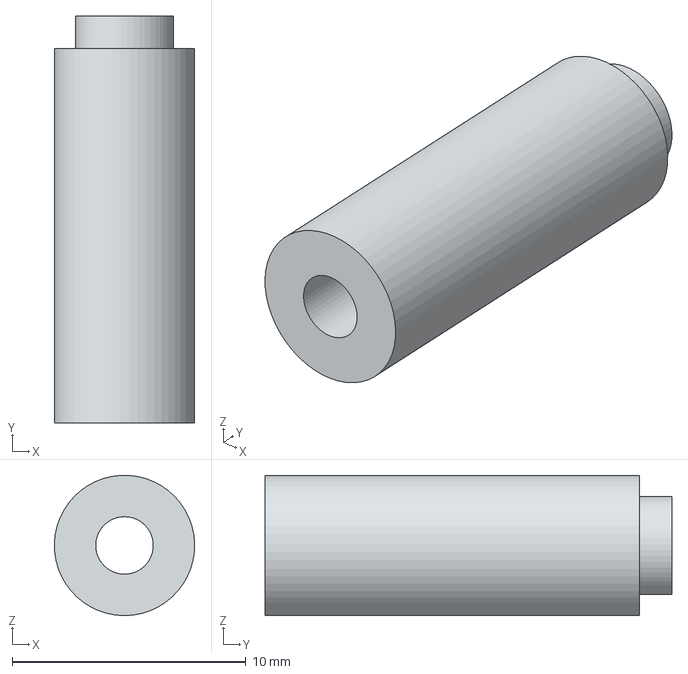
[picture p63: CAD file, 2023-07-14]
3D/Components/STP_9774160360 (rev1).stp
6.00 x 17.4 x 5.99 mm
