jazari-akuna/lib-elec/3D/Components/User Library-01530007Z.step

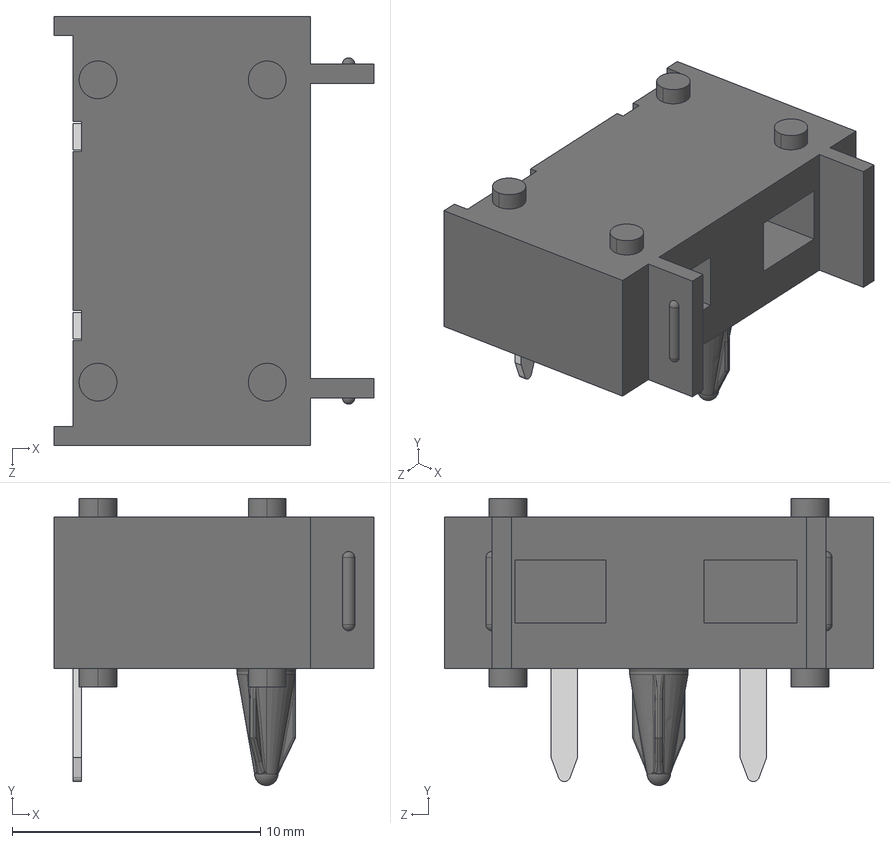
[picture p64: CAD file, 2023-07-14]
3D/Components/User Library-01530007Z.step
12.9 x 11.6 x 17.3 mm
