jazari-akuna/lib-elec/3D/Connectors/FTSH-107-01-L-DV-K.step

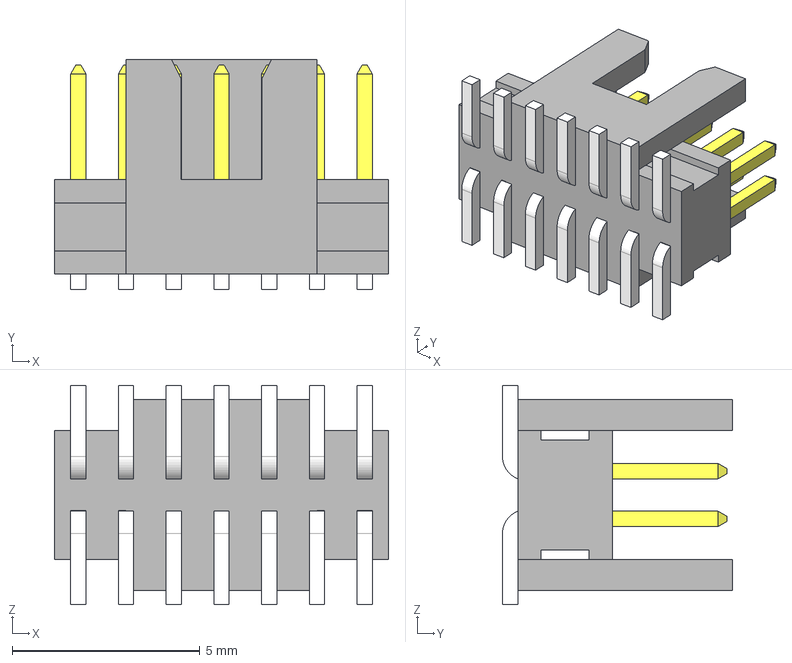
[picture p65: CAD file, 2022-11-27]
3D/Connectors/FTSH-107-01-L-DV-K.step
8.89 x 6.12 x 5.84 mm
FTSH-107-01-L-DV-K_pins2
FTSH-107-01-L-DV-K_pins1
FTSH-107-01-L-DV-K_body
