jazari-akuna/lib-elec/3D/Connectors/Banana Plug 4mm Black CT2238 v1.stp

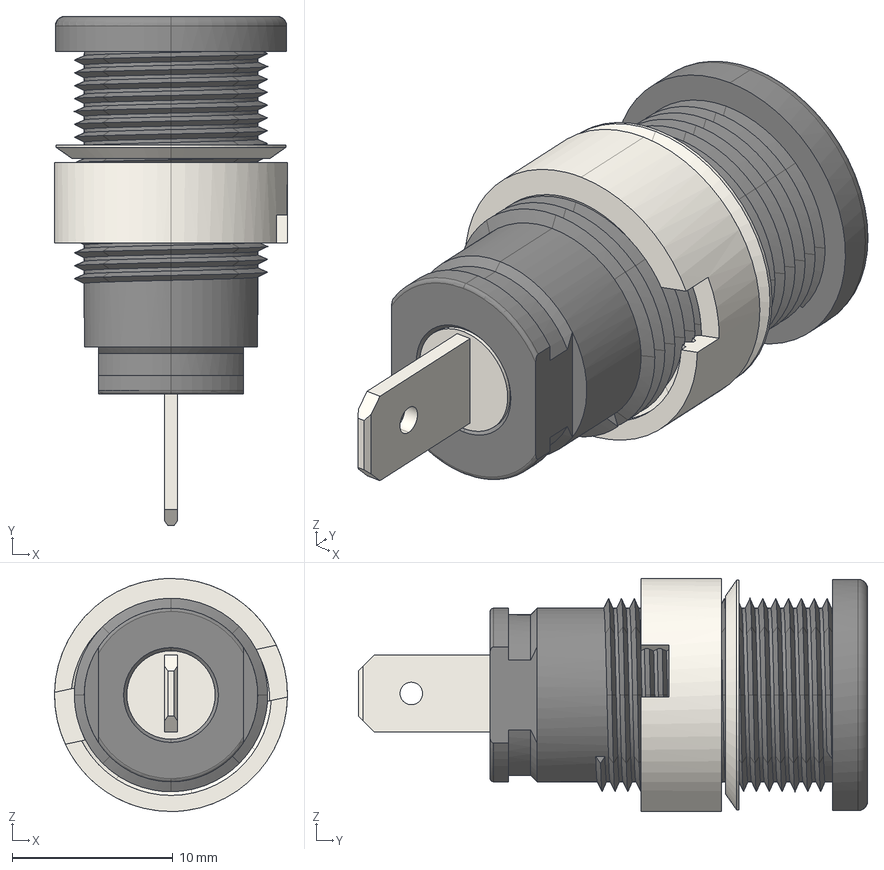
[picture p66: CAD file, 2022-11-11]
3D/Connectors/Banana Plug 4mm Black CT2238 v1.stp
14.5 x 31.7 x 14.5 mm
User Library-Stor banan_Stor banan bricka
User Library-Stor banan_Stor banan mutter
User Library-Stor banan_Stor banan
User Library-Stor banan_Stor banan koppar
