jazari-akuna/lib-elec/3D/Components/LDR Pedestal.stp

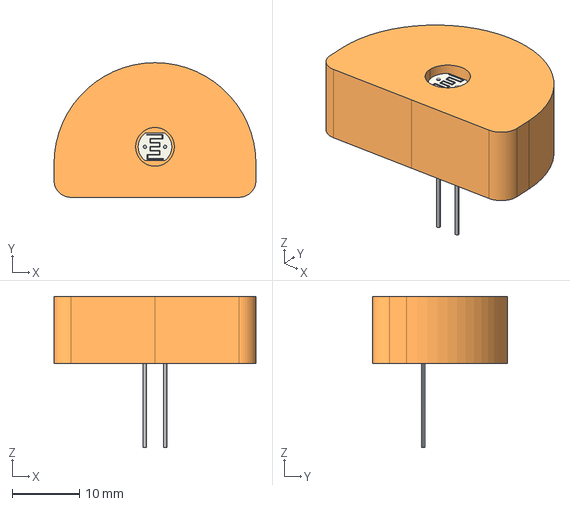
[picture p67: CAD file, 2023-01-10]
3D/Components/LDR Pedestal.stp
30.0 x 20.0 x 22.5 mm
SupportLDR
R_LDR_5.0x4.1mm_P3mm_Vertical
