jazari-akuna/lib-elec/3D/Components/Download_STP_830030819 (rev1).stp

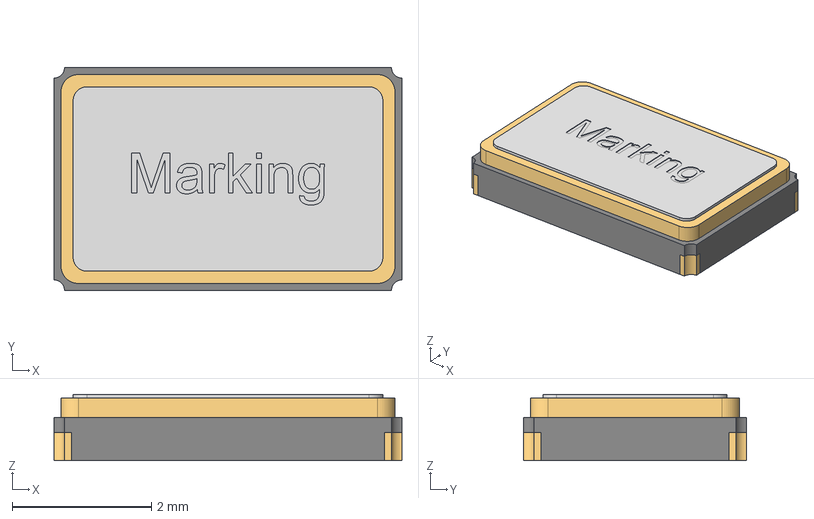
[picture p68: CAD file, 2022-12-05]
3D/Components/Download_STP_830030819 (rev1).stp
5.00 x 3.20 x 0.95 mm
Pins
Cover
