jazari-akuna/lib-elec/3D/Connectors/S03B-PASK-2.stp

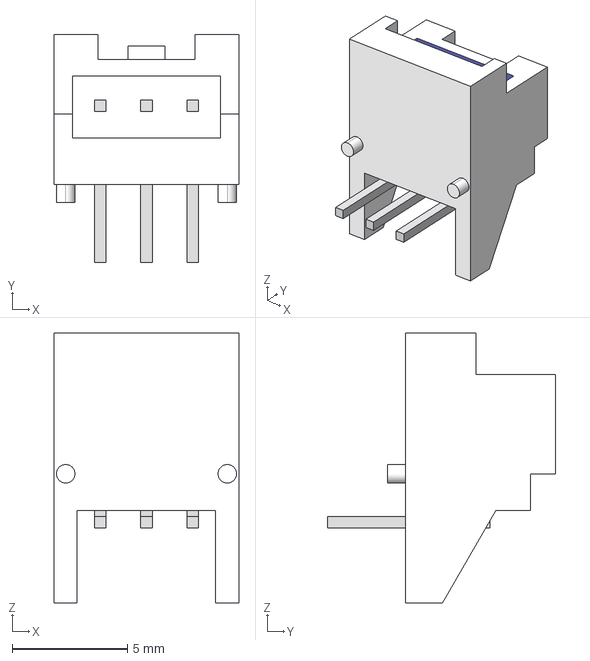
[picture p69: CAD file, 2022-06-21]
3D/Connectors/S03B-PASK-2.stp
8.00 x 9.90 x 11.7 mm
