jazari-akuna/lib-elec/3D/Connectors/User Library-xt30upb-m.STEP

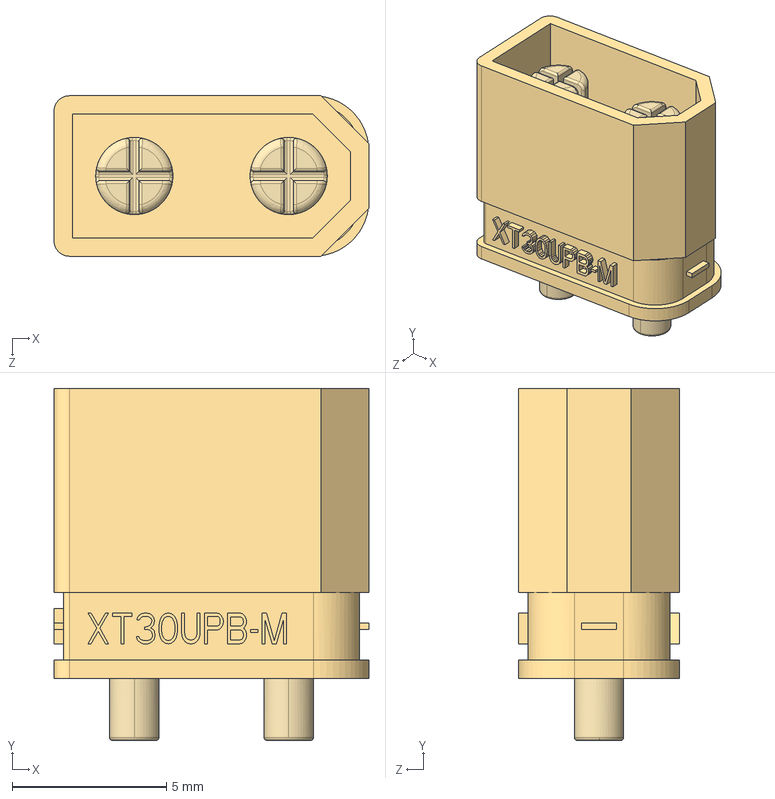
[picture p70: CAD file, 2022-06-21]
3D/Connectors/User Library-xt30upb-m.STEP
10.2 x 11.4 x 5.20 mm
XT30UPB-M
XT30UPB-M-PIN x 2
