jazari-akuna/lib-elec/3D/Components/POWERSSO-36TP_STM.step

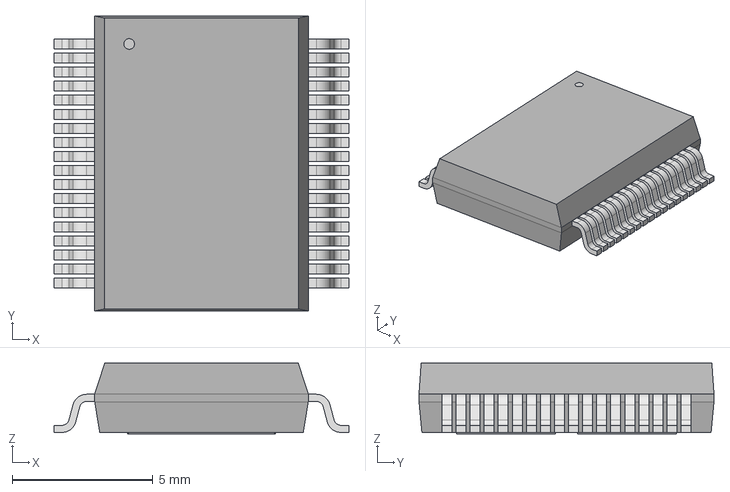
[picture p71: CAD file, 2022-12-05]
3D/Components/POWERSSO-36TP_STM.step
10.5 x 10.5 x 2.52 mm
