jazari-akuna/lib-elec/3D/Components/sc705_model.STEP

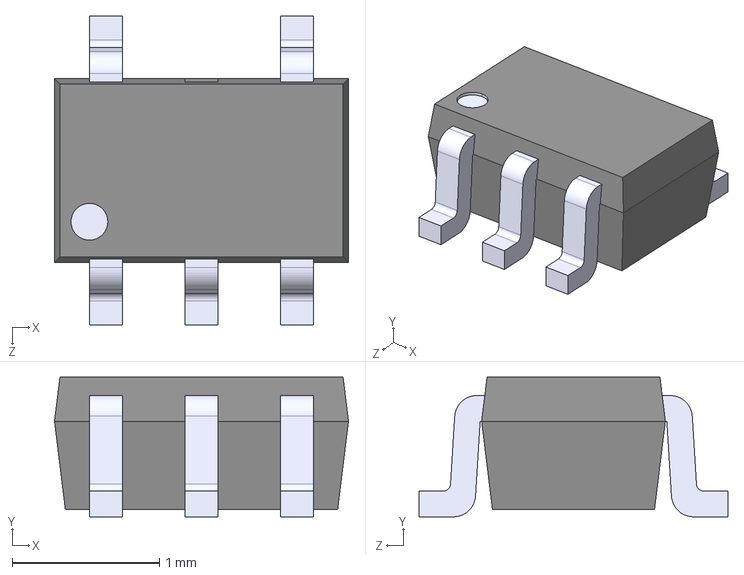
[picture p72: CAD file, 2022-11-27]
3D/Components/sc705_model.STEP
2.00 x 0.95 x 2.10 mm
sc705_pin x 5
SC705_0M65_2MX1M25X0M9
