jazari-akuna/lib-elec/3D/Components/MPRLS0025PA00001A.step

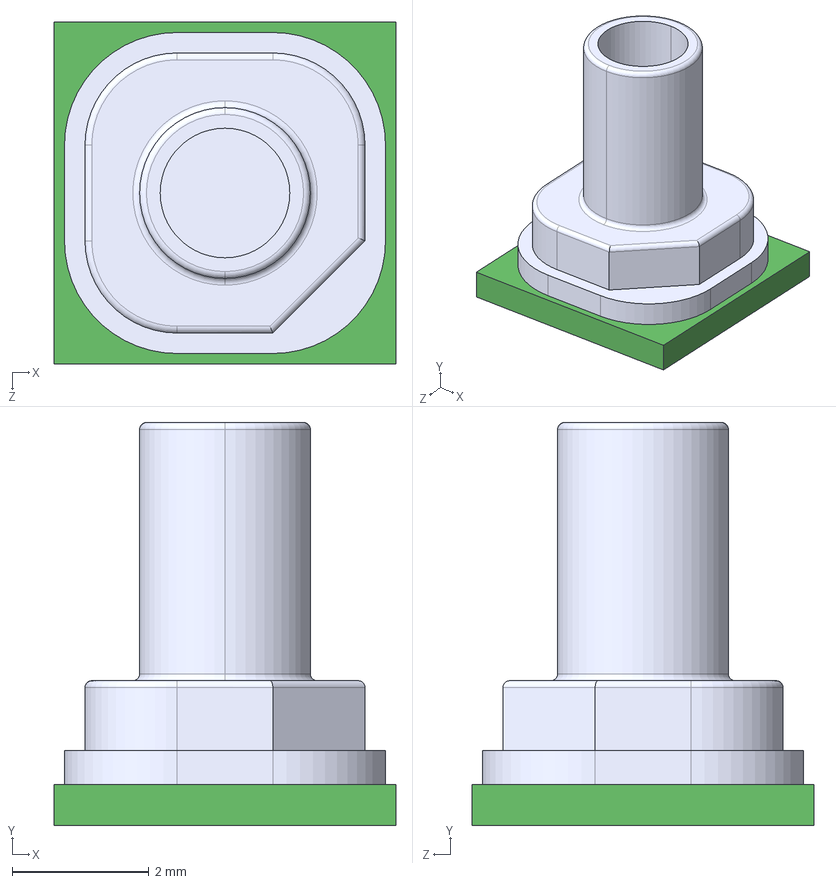
[picture p73: CAD file, 2022-06-21]
3D/Components/MPRLS0025PA00001A.step
5.00 x 5.90 x 5.00 mm
