jazari-akuna/lib-elec/3D/Connectors/684M7W2103L461.stp

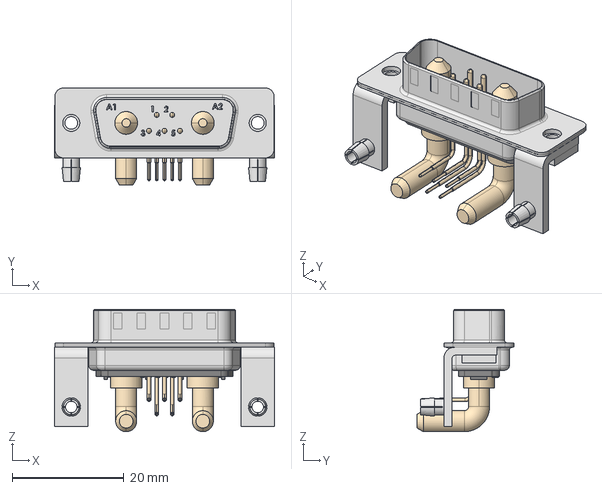
[picture p74: CAD file, 2021-11-08]
3D/Connectors/684M7W2103L461.stp
39.3 x 17.3 x 21.9 mm
