jazari-akuna/lib-elec/3D/Components/0031-7701-11.STEP

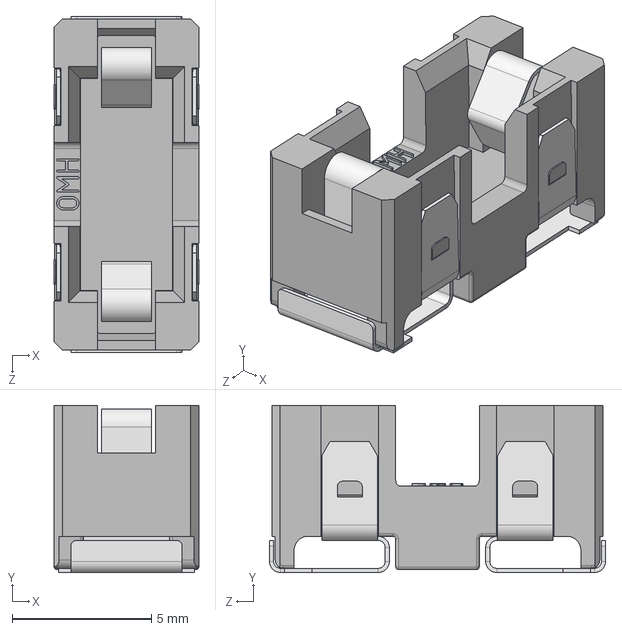
[picture p75: CAD file, 2022-06-21]
3D/Components/0031-7701-11.STEP
5.20 x 6.00 x 12.1 mm
