jazari-akuna/lib-elec/3D/Connectors/681M7W2103L001.stp

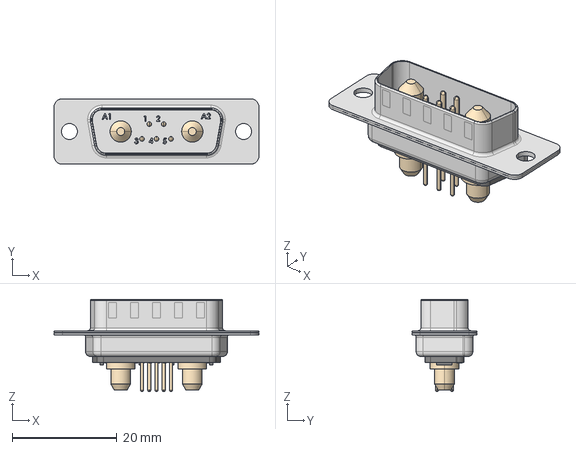
[picture p76: CAD file, 2021-10-23]
3D/Connectors/681M7W2103L001.stp
39.2 x 12.5 x 17.6 mm
