jazari-akuna/lib-elec/3D/Components/SN74LVC2G02DCUR.STEP

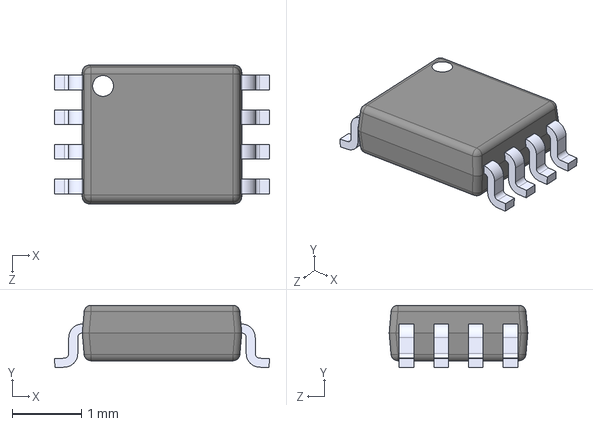
[picture p77: CAD file, 2021-11-08]
3D/Components/SN74LVC2G02DCUR.STEP
3.10 x 0.9 x 2.00 mm
