jazari-akuna/lib-elec/3D/Connectors/JST - XH - Thru V - 5Pin - 2.54mm.stp

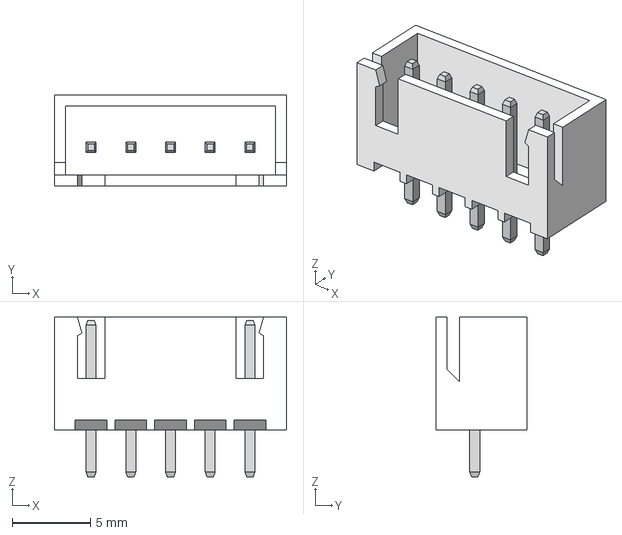
[picture p78: CAD file, 2021-10-23]
3D/Connectors/JST - XH - Thru V - 5Pin - 2.54mm.stp
14.8 x 5.84 x 10.2 mm
