jazari-akuna/lib-elec/3D/Components/DO-214AB.STEP

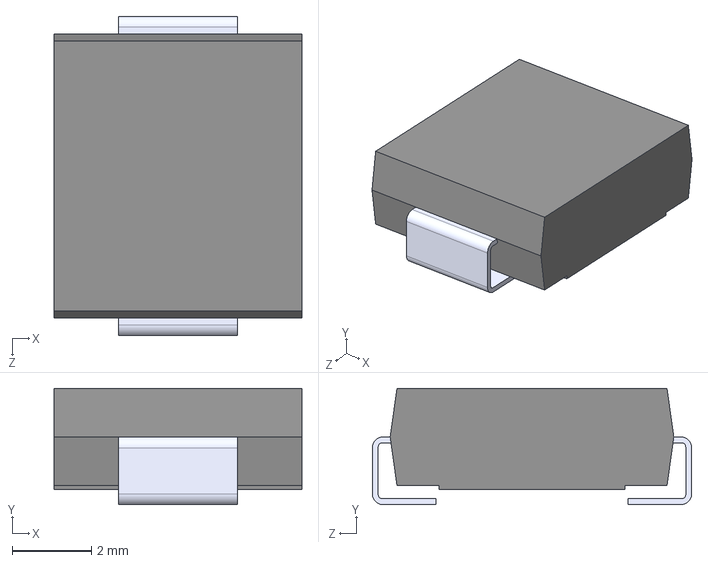
[picture p79: CAD file, 2021-10-21]
3D/Components/DO-214AB.STEP
6.25 x 2.93 x 8.05 mm
