jazari-akuna/lib-elec/3D/Components/THL_25-2412WI.step

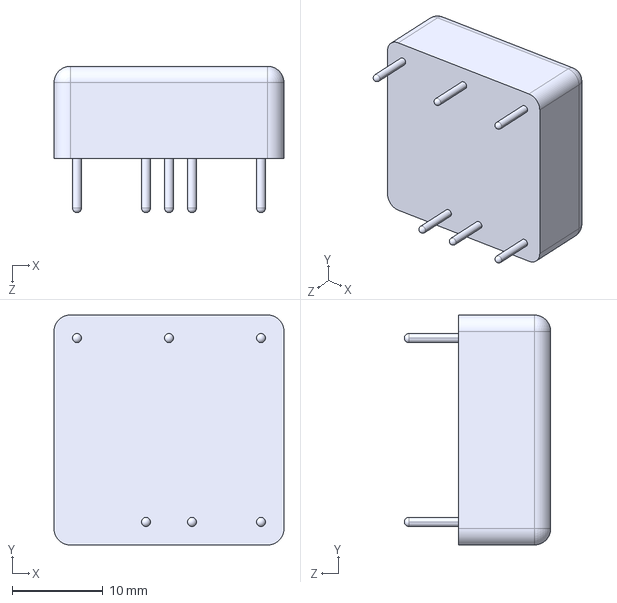
[picture p80: CAD file, 2021-08-13]
3D/Components/THL_25-2412WI.step
25.4 x 25.4 x 16.2 mm
