jazari-akuna/lib-elec/3D/Components/TEN_60-2412WIN.step

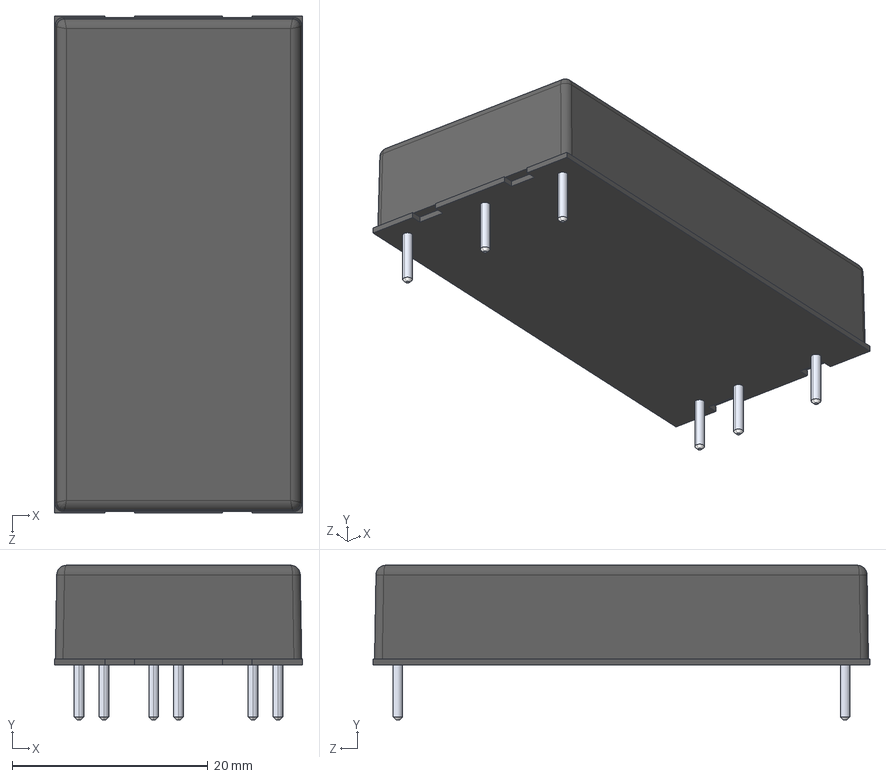
[picture p81: CAD file, 2021-08-13]
3D/Components/TEN_60-2412WIN.step
25.4 x 15.8 x 50.8 mm
