jazari-akuna/lib-elec/3D/Connectors/c-292303-1-e4-3d.stp

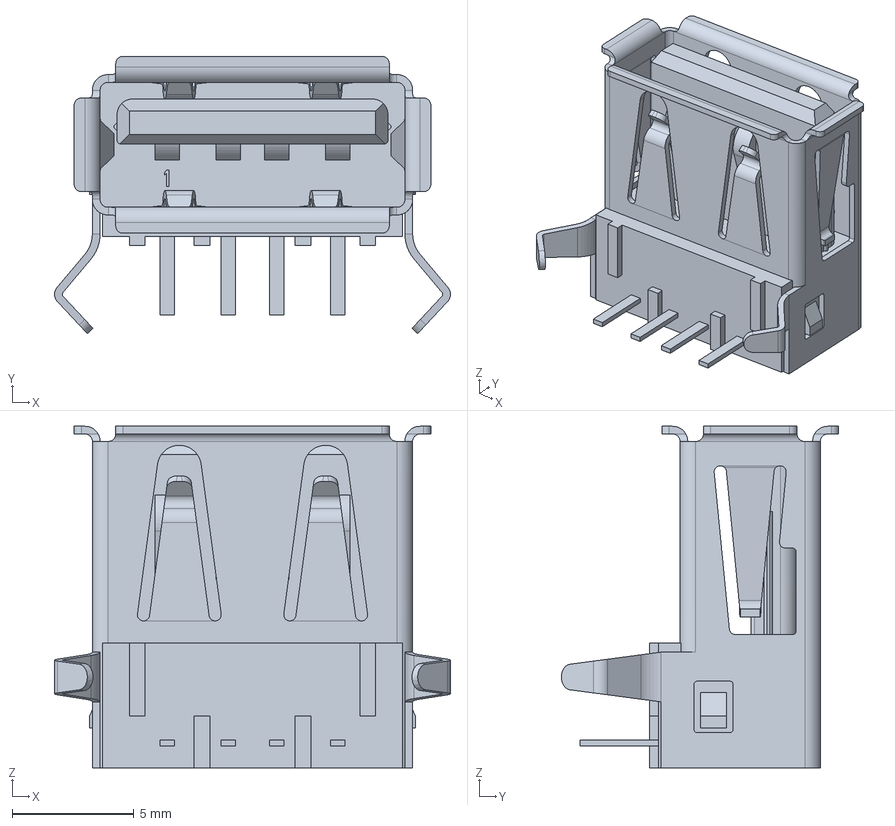
[picture p82: CAD file, 2021-08-03]
3D/Connectors/c-292303-1-e4-3d.stp
16.2 x 11.4 x 14.0 mm
