jazari-akuna/lib-elec/3D/Components/TDN_5-2410WI.step

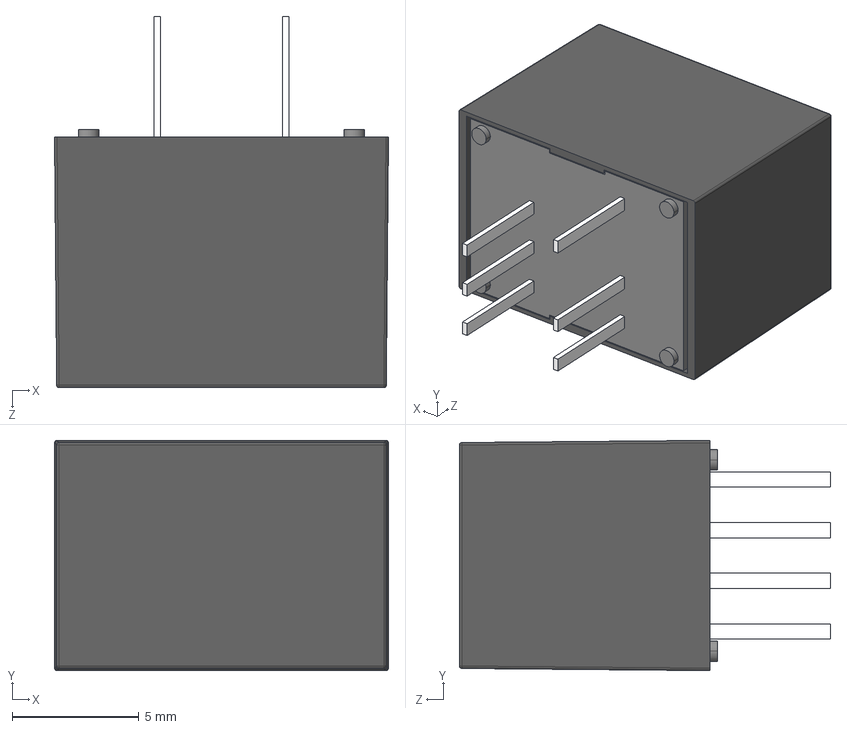
[picture p83: CAD file, 2021-08-13]
3D/Components/TDN_5-2410WI.step
13.2 x 9.10 x 14.7 mm
