jazari-akuna/lib-elec/3D/Components/LTC4353IMS#PBF.STEP

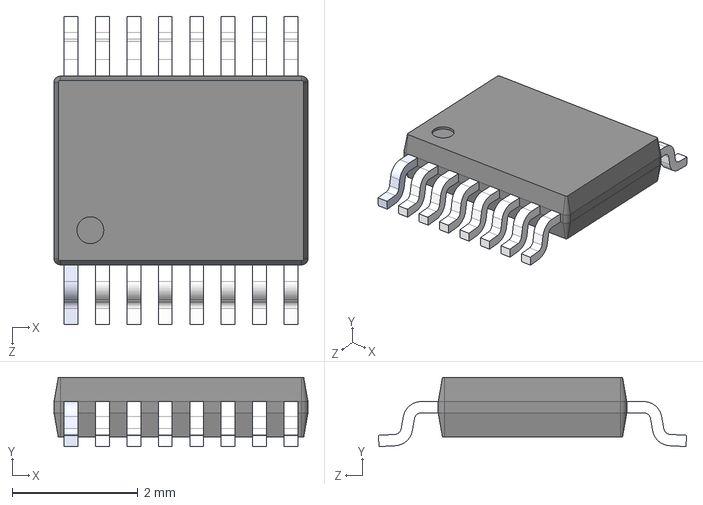
[picture p84: CAD file, 2021-03-30]
3D/Components/LTC4353IMS#PBF.STEP
4.04 x 1.10 x 4.90 mm
