jazari-akuna/lib-elec/3D/Components/Download_STP_WL-SBTW-3528 (rev1).stp

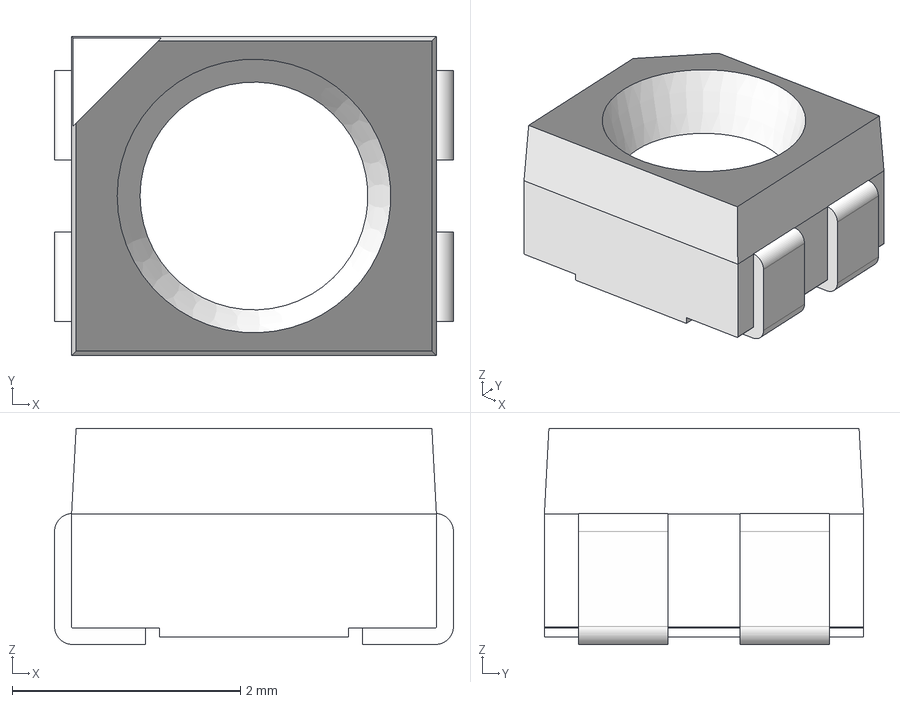
[picture p85: CAD file, 2021-03-30]
3D/Components/Download_STP_WL-SBTW-3528 (rev1).stp
3.50 x 2.80 x 1.90 mm
cover
housing
base x 2
