jazari-akuna/lib-elec/3D/Components/DC_Fan_20x20x10.stp

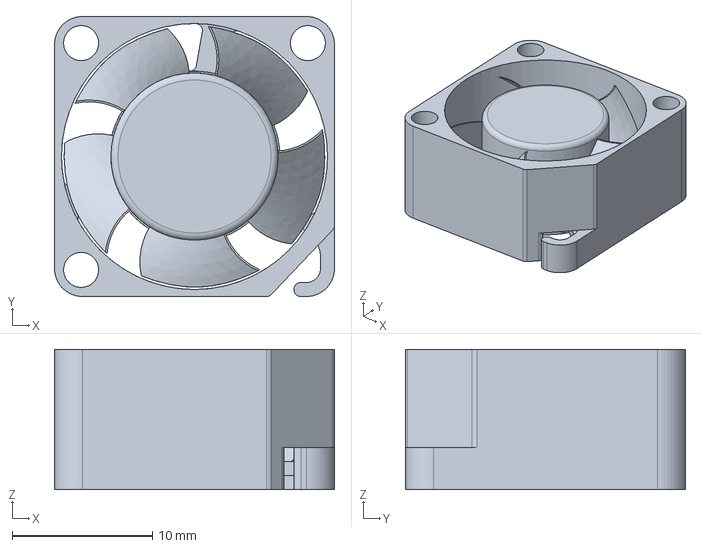
[picture p86: CAD file, 2021-01-25]
3D/Components/DC_Fan_20x20x10.stp
20.0 x 20.0 x 10.0 mm
