jazari-akuna/lib-elec/3D/Components/SI7994DP-T1-GE3.STEP

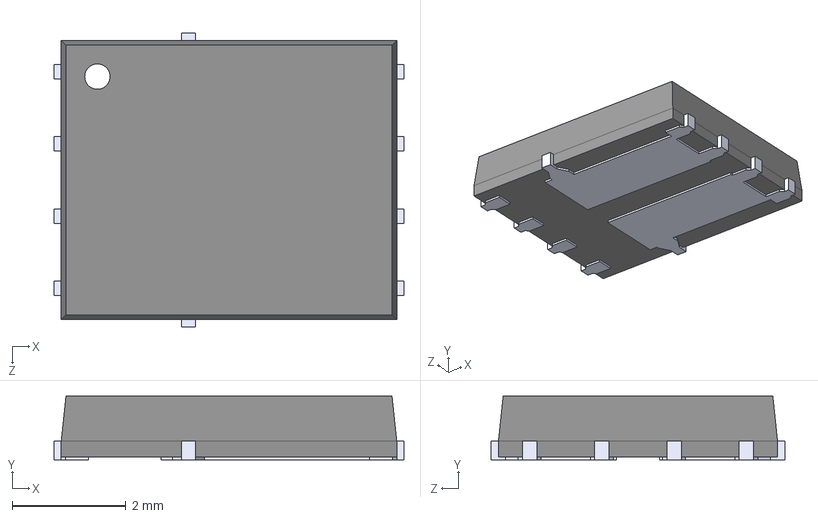
[picture p87: CAD file, 2021-01-24]
3D/Components/SI7994DP-T1-GE3.STEP
6.15 x 1.12 x 5.16 mm
