jazari-akuna/lib-elec/3D/Components/40x40x10 DC Fan.STEP

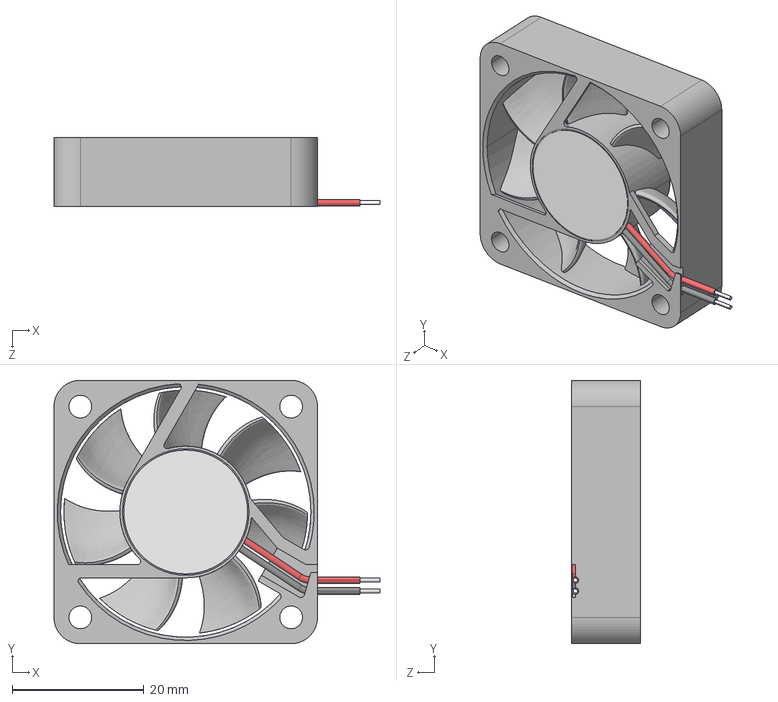
[picture p88: CAD file, 2020-12-29]
3D/Components/40x40x10 DC Fan.STEP
49.5 x 40.0 x 10.5 mm
