jazari-akuna/lib-elec/3D/Components/44 0xx6 7082 622 (rev1).stp

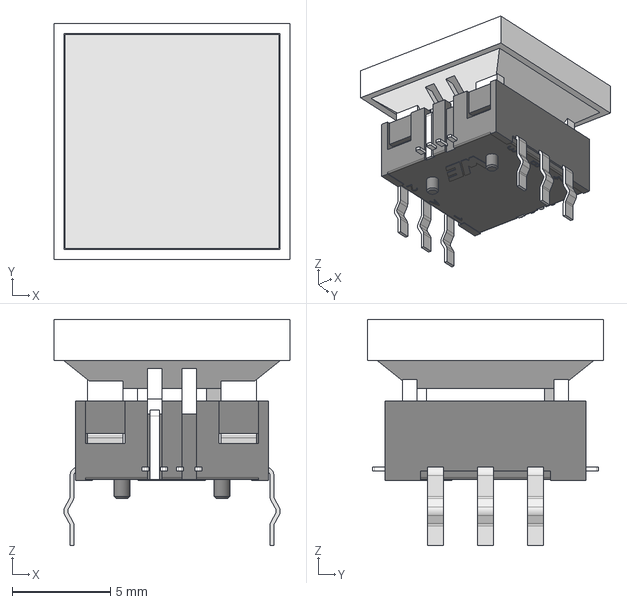
[picture p89: CAD file, 2020-12-28]
3D/Components/44 0xx6 7082 622 (rev1).stp
12.0 x 12.0 x 11.5 mm
