jazari-akuna/lib-elec/3D/Components/PLCC-4-Led.STEP

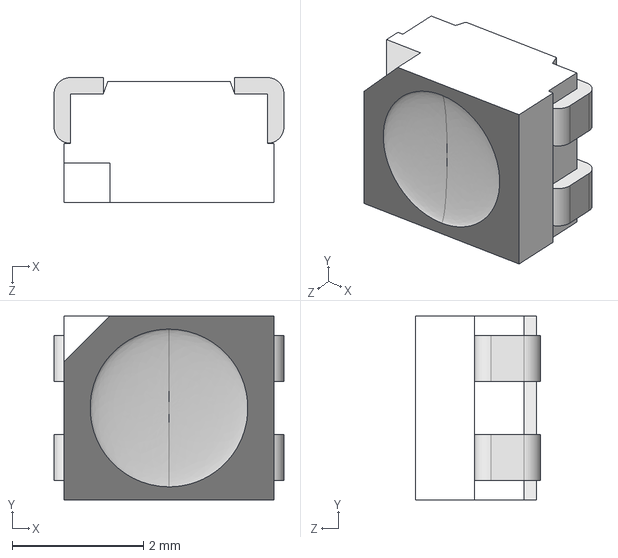
[picture p90: CAD file, 2020-12-25]
3D/Components/PLCC-4-Led.STEP
3.50 x 2.80 x 1.90 mm
