jazari-akuna/lib-elec/3D/Components/User Library-PTN78020.step

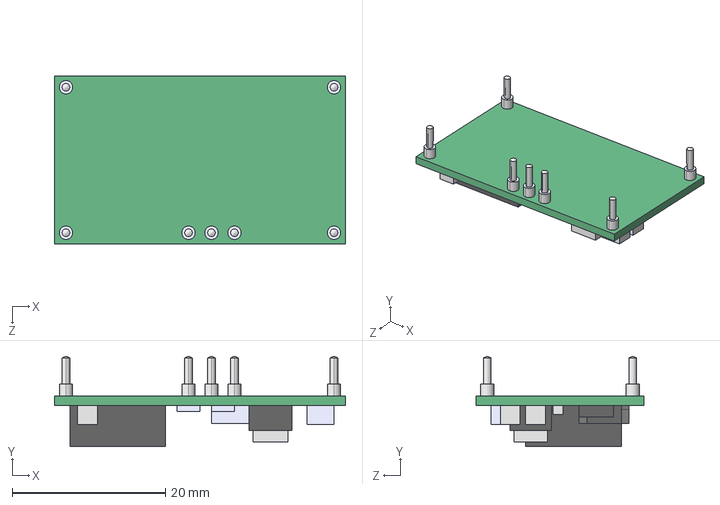
[picture p91: CAD file, 2020-06-12]
3D/Components/User Library-PTN78020.step
38.0 x 11.8 x 22.0 mm
