jazari-akuna/lib-elec/3D/Connectors/B5B-XH-AM.stp

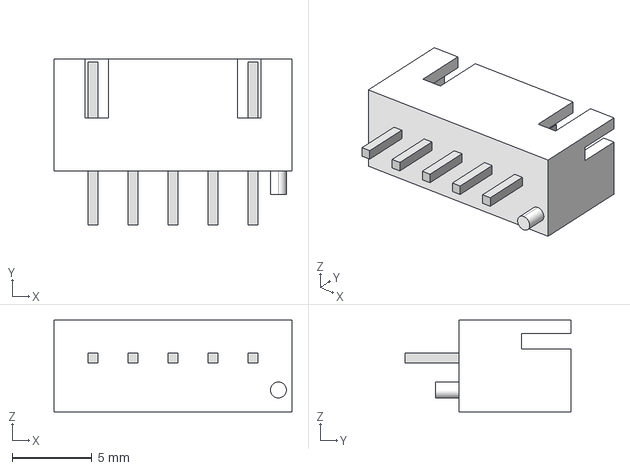
[picture p92: CAD file, 2020-12-25]
3D/Connectors/B5B-XH-AM.stp
14.9 x 10.4 x 5.75 mm
