jazari-akuna/lib-elec/3D/Components/8040.0001_03.STEP

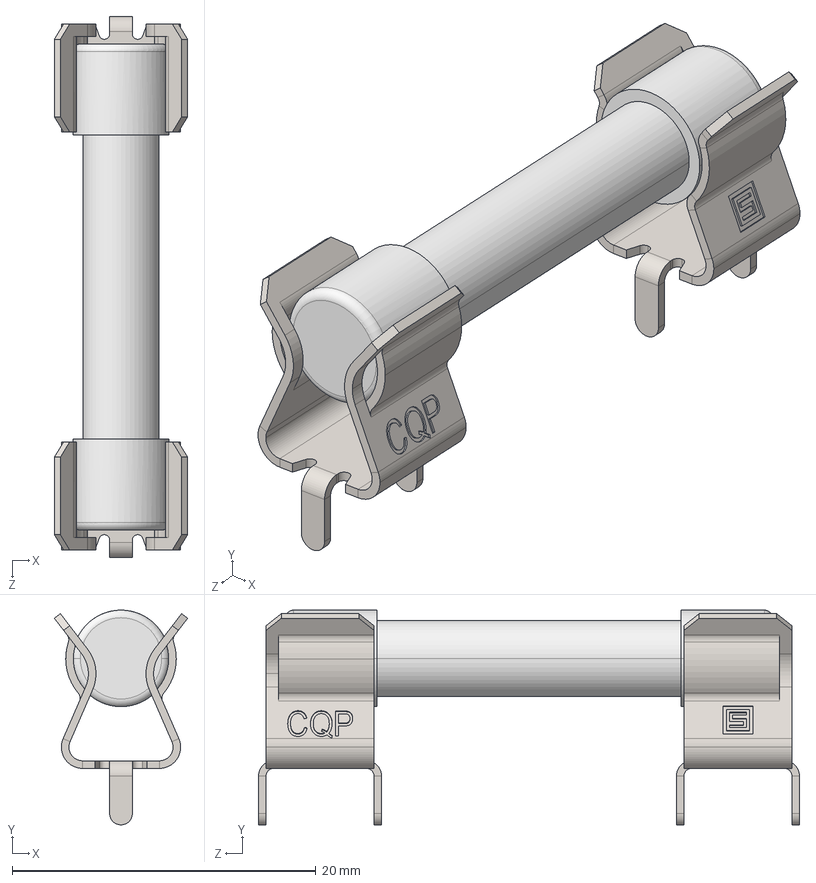
[picture p93: CAD file, 2020-06-12]
3D/Components/8040.0001_03.STEP
8.77 x 14.1 x 35.6 mm
