jazari-akuna/lib-elec/3D/Connectors/S04B-PASK-2.stp

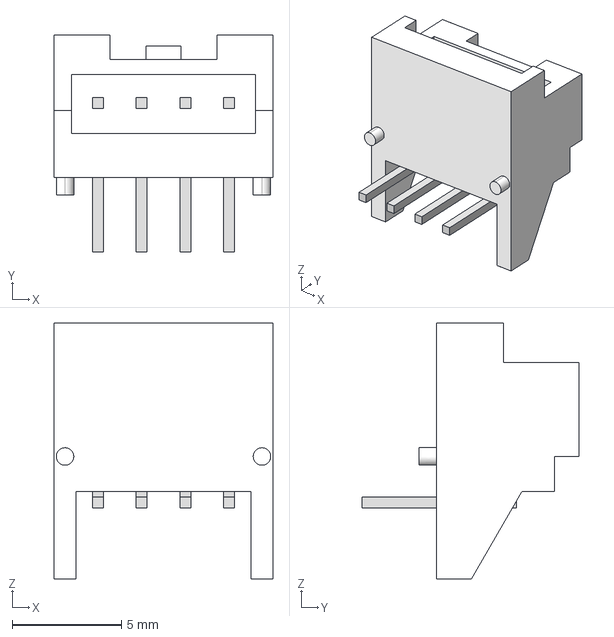
[picture p94: CAD file, 2020-06-12]
3D/Connectors/S04B-PASK-2.stp
10.0 x 9.90 x 11.7 mm
