jazari-akuna/lib-elec/3D/Connectors/B04B-PASK-1.stp

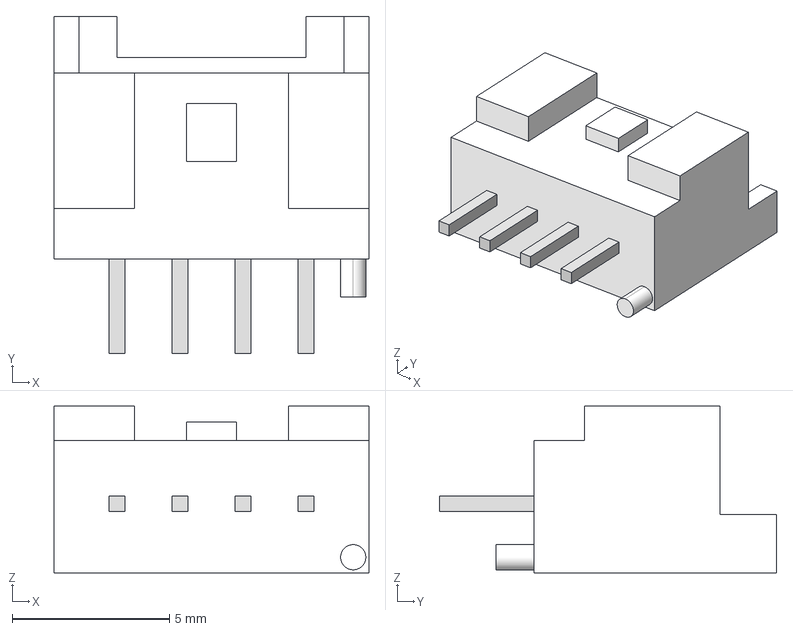
[picture p95: CAD file, 2020-06-12]
3D/Connectors/B04B-PASK-1.stp
10.0 x 10.7 x 5.30 mm
