jazari-akuna/lib-elec/3D/Connectors/B06B-PASK-1.stp

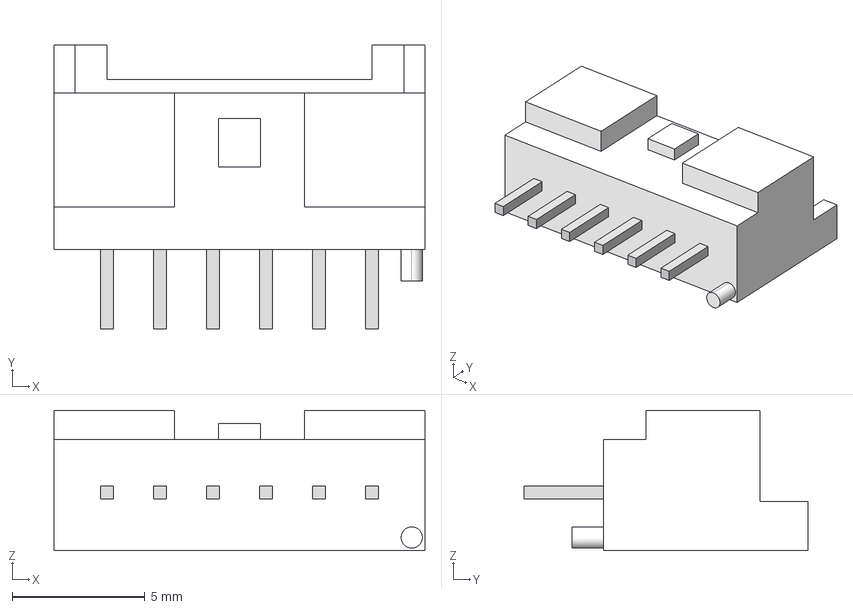
[picture p97: CAD file, 2020-06-12]
3D/Connectors/B06B-PASK-1.stp
14.0 x 10.7 x 5.30 mm
