jazari-akuna/lib-elec/3D/Connectors/S02B-PASK-2.stp

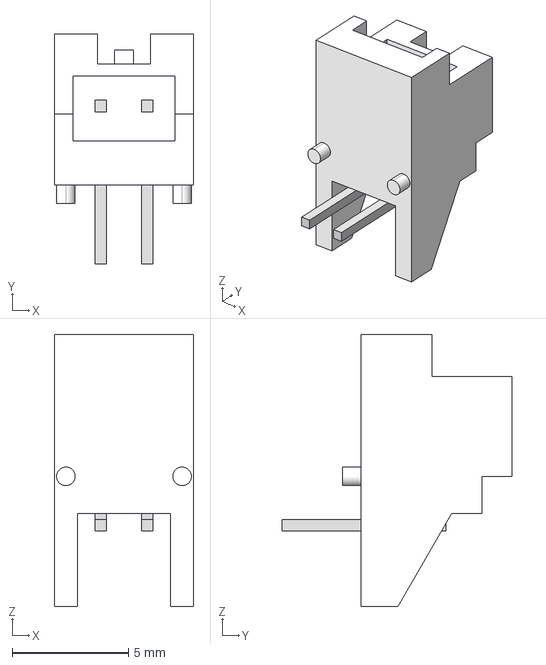
[picture p98: CAD file, 2020-06-12]
3D/Connectors/S02B-PASK-2.stp
6.00 x 9.90 x 11.7 mm
