jazari-akuna/lib-elec/3D/Connectors/2604-3102.stp

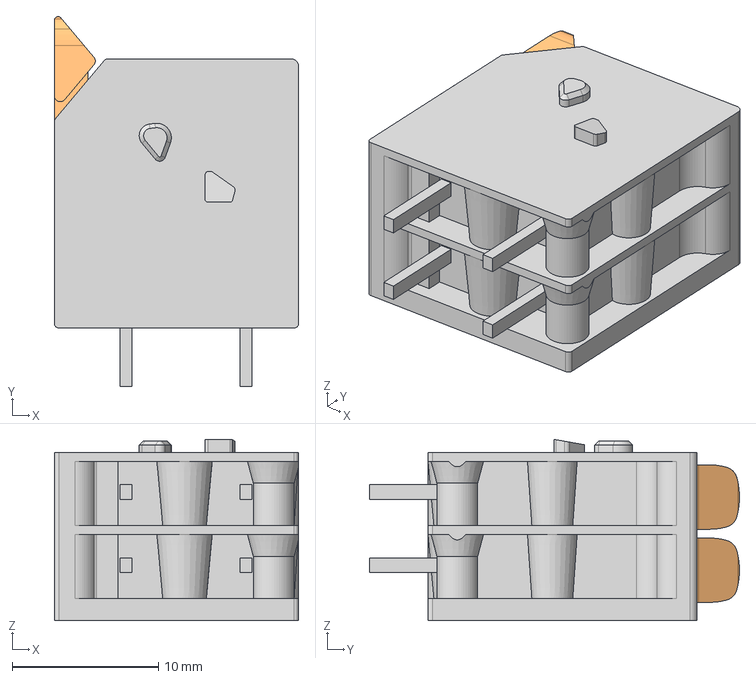
[picture p99: CAD file, 2020-06-12]
3D/Connectors/2604-3102.stp
16.7 x 25.3 x 12.4 mm
