jazari-akuna/lib-elec/3D/Connectors/B05B-PASK-1.stp

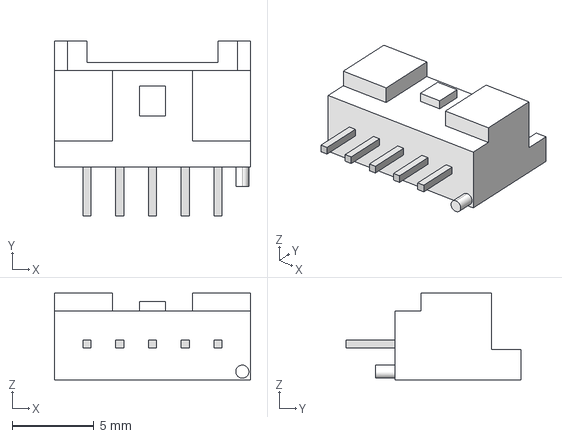
[picture p100: CAD file, 2020-06-12]
3D/Connectors/B05B-PASK-1.stp
12.0 x 10.7 x 5.30 mm
