jazari-akuna/lib-elec/3D/Connectors/B02B-PASK-1.stp

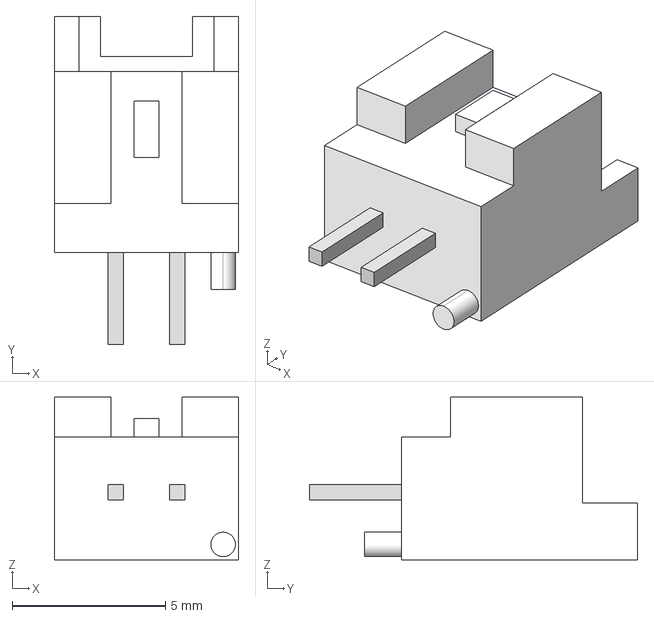
[picture p101: CAD file, 2020-06-12]
3D/Connectors/B02B-PASK-1.stp
6.00 x 10.7 x 5.30 mm
