jazari-akuna/lib-elec/(list of files, cad)

Other CAD files:
3D/Components/STP_435431019840 (rev1).stp
3D/Connectors/Banana Plug 4mm Red CT2238 v1.step
3D/Connectors/ESQ-120-24-T-D.stp
3D/Board/Adafruit BMP390/Src/61300811821/61300811821 (rev1).CATProduct
3D/Board/Adafruit BMP390/Src/61300811821/61300811821.CATPart
3D/Board/Adafruit BMP390/Src/61300811821/6130xx11821_PIN.CATPart
3D/Board/Adafruit BMP390/Src/9774085151.CATPart
3D/Board/Adafruit BMP390/Src/Adafruit BMP390 THT.CATProduct
3D/Board/Adafruit BMP390/Src/Adafruit BMP390/10K.CATPart
3D/Board/Adafruit BMP390/Src/Adafruit BMP390/10K_1.CATPart
3D/Board/Adafruit BMP390/Src/Adafruit BMP390/10uF.CATPart
3D/Board/Adafruit BMP390/Src/Adafruit BMP390/1N4148.CATPart
3D/Board/Adafruit BMP390/Src/Adafruit BMP390/AP2112K-3.3.CATPart
3D/Board/Adafruit BMP390/Src/Adafruit BMP390/Adafruit BMP390.CATProduct
3D/Board/Adafruit BMP390/Src/Adafruit BMP390/BMP388.CATPart
3D/Board/Adafruit BMP390/Src/Adafruit BMP390/BSS138.CATPart
3D/Board/Adafruit BMP390/Src/Adafruit BMP390/Board.CATPart
3D/Board/Adafruit BMP390/Src/Adafruit BMP390/GREEN.CATPart
3D/Board/Adafruit BMP390/Src/Adafruit BMP390/SOLID.1.CATPart
3D/Board/Adafruit BMP390/Src/Adafruit BMP390/STEMMA_I2C_QT.CATPart
3D/Board/Adafruit BNO085/Src/61300611121.CATPart
3D/Board/Adafruit BNO085/Src/61300611821 (rev1).CATProduct
3D/Board/Adafruit BNO085/Src/61300611821.CATPart
3D/Board/Adafruit BNO085/Src/6130xx11121_PIN.CATPart
3D/Board/Adafruit BNO085/Src/6130xx11821_PIN.CATPart
3D/Board/Adafruit BNO085/Src/9774085151.CATPart
3D/Board/Adafruit BNO085/Src/Adafruit BNO085 with SMD Spacers.CATProduct
3D/Board/Adafruit BNO085/Src/Adafruit BNO085.CATProduct
3D/Board/Adafruit BNO085/Src/BNO085-9axis-IMU.CATPart
3D/Board/Adafruit BNO085/Src/BODY-TSSOP.CATPart
3D/Board/Adafruit BNO085/Src/BSS138PS.CATPart
3D/Board/Adafruit BNO085/Src/CAPC-0603-T0.9-BN.CATPart
3D/Board/Adafruit BNO085/Src/CAPC-0805-T0.95-BN.CATPart
3D/Board/Adafruit BNO085/Src/Crystal_XTAL3215_32.768KHz.CATPart
3D/Board/Adafruit BNO085/Src/Download_STP_61300611121 (rev1)(1).CATProduct
3D/Board/Adafruit BNO085/Src/LEAD-TSSOP.CATPart
3D/Board/Adafruit BNO085/Src/LED 0603 single color.CATPart
3D/Board/Adafruit BNO085/Src/Printed Circuit Board.CATPart
3D/Board/Adafruit BNO085/Src/SOT23-5.CATPart
3D/Board/Adafruit BNO085/Src/YC164_RESPACK.CATPart
3D/Board/Adafruit BNO085/Src/qwicc.CATPart
3D/Board/Adafruit SD Breakout/Src/61300911821/61300911821 (rev1).CATProduct
3D/Board/Adafruit SD Breakout/Src/61300911821/61300911821.CATPart
3D/Board/Adafruit SD Breakout/Src/61300911821/6130xx11821_PIN.CATPart
3D/Board/Adafruit SD Breakout/Src/970120151.CATPart
3D/Board/Adafruit SD Breakout/Src/Adafruit SD Breakout/0.1uF.CATPart
3D/Board/Adafruit SD Breakout/Src/Adafruit SD Breakout/10uF.3.CATPart
3D/Board/Adafruit SD Breakout/Src/Adafruit SD Breakout/47K.CATPart
3D/Board/Adafruit SD Breakout/Src/Adafruit SD Breakout/Adafruit SD Breakout.CATProduct
3D/Board/Adafruit SD Breakout/Src/Adafruit SD Breakout/Board.1.CATPart
3D/Board/Adafruit SD Breakout/Src/Adafruit SD Breakout/SOLID.2.CATPart
3D/Board/Adafruit SD Breakout/Src/Adafruit SD Breakout/microSD.CATPart
3D/Board/NodeMCU Esp32/Src/BUTTONFLASH-13_2.CATPart
3D/Board/NodeMCU Esp32/Src/BUTTONFLASH-14_2.CATPart
3D/Board/NodeMCU Esp32/Src/MICROCHIP_2.CATPart
3D/Board/NodeMCU Esp32/Src/NodeMCU Esp32.CATProduct
3D/Board/NodeMCU Esp32/Src/PCB.CATPart
3D/Board/NodeMCU Esp32/Src/PIN.CATPart
3D/Board/NodeMCU Esp32/Src/RECTANGULARCHIP_2.CATPart
3D/Board/NodeMCU Esp32/Src/RESISTOR1_2.CATPart
3D/Board/NodeMCU Esp32/Src/RESISTOR2-32_2.CATPart
3D/Board/NodeMCU Esp32/Src/SSQ-115-01-G-S.CATProduct
3D/Board/NodeMCU Esp32/Src/TANCHIP_2.CATPart
3D/Board/NodeMCU Esp32/Src/TRANSISTOR_3-LEG2_2.CATPart
3D/Board/NodeMCU Esp32/Src/TRANSISTOR_3-LEG_2.CATPart
3D/Board/NodeMCU Esp32/Src/USB_SOCKET_2.CATPart
3D/Board/NodeMCU Esp32/Src/WIFI_CARD_2.CATPart
3D/Board/NodeMCU Esp32/Src/_P2SSQ-115-01-G-S.CATPart
3D/Board/NodeMCU Esp32/Src/_T1SSQ-115-01-G-S.CATPart
3D/Board/Nucleo F303K8/Src/61001613321 (rev1).CATProduct
3D/Board/Nucleo F303K8/Src/61001613321 (rev1).stp
3D/Board/Nucleo F303K8/Src/6100161xx21.CATPart
3D/Board/Nucleo F303K8/Src/6100xx1xx21_PIN.CATPart
3D/Board/Nucleo F303K8/Src/ABS07-120.CATPart
3D/Board/Nucleo F303K8/Src/Extruded.CATPart
3D/Board/Nucleo F303K8/Src/Extruded_1.CATPart
3D/Board/Nucleo F303K8/Src/Extruded_10.CATPart
3D/Board/Nucleo F303K8/Src/Extruded_11.CATPart
3D/Board/Nucleo F303K8/Src/Extruded_12.CATPart
3D/Board/Nucleo F303K8/Src/Extruded_13.CATPart
3D/Board/Nucleo F303K8/Src/Extruded_14.CATPart
3D/Board/Nucleo F303K8/Src/Extruded_15.CATPart
3D/Board/Nucleo F303K8/Src/Extruded_16.CATPart
3D/Board/Nucleo F303K8/Src/Extruded_17.CATPart
3D/Board/Nucleo F303K8/Src/Extruded_18.CATPart
3D/Board/Nucleo F303K8/Src/Extruded_19.CATPart
3D/Board/Nucleo F303K8/Src/Extruded_2.CATPart
3D/Board/Nucleo F303K8/Src/Extruded_20.CATPart
3D/Board/Nucleo F303K8/Src/Extruded_21.CATPart
3D/Board/Nucleo F303K8/Src/Extruded_22.CATPart
3D/Board/Nucleo F303K8/Src/Extruded_23.CATPart
3D/Board/Nucleo F303K8/Src/Extruded_24.CATPart
3D/Board/Nucleo F303K8/Src/Extruded_25.CATPart
3D/Board/Nucleo F303K8/Src/Extruded_26.CATPart
3D/Board/Nucleo F303K8/Src/Extruded_27.CATPart
3D/Board/Nucleo F303K8/Src/Extruded_28.CATPart
3D/Board/Nucleo F303K8/Src/Extruded_29.CATPart
3D/Board/Nucleo F303K8/Src/Extruded_3.CATPart
3D/Board/Nucleo F303K8/Src/Extruded_30.CATPart
3D/Board/Nucleo F303K8/Src/Extruded_31.CATPart
3D/Board/Nucleo F303K8/Src/Extruded_32.CATPart
3D/Board/Nucleo F303K8/Src/Extruded_33.CATPart
3D/Board/Nucleo F303K8/Src/Extruded_34.CATPart
3D/Board/Nucleo F303K8/Src/Extruded_35.CATPart
3D/Board/Nucleo F303K8/Src/Extruded_36.CATPart
3D/Board/Nucleo F303K8/Src/Extruded_4.CATPart
3D/Board/Nucleo F303K8/Src/Extruded_5.CATPart
3D/Board/Nucleo F303K8/Src/Extruded_6.CATPart
3D/Board/Nucleo F303K8/Src/Extruded_7.CATPart
3D/Board/Nucleo F303K8/Src/Extruded_8.CATPart
3D/Board/Nucleo F303K8/Src/Extruded_9.CATPart
3D/Board/Nucleo F303K8/Src/MB1180 - SMD.CATProduct
3D/Board/Nucleo F303K8/Src/MB1180.CATProduct
3D/Board/Nucleo F303K8/Src/Open CASCADE STEP translator 6.8 1.1.1.CATPart
3D/Board/Nucleo F303K8/Src/Open CASCADE STEP translator 6.8 1.4.1.1.CATPart
3D/Board/Nucleo F411RE/Src/Nucleo F411RE with Header.CATProduct
3D/Board/Nucleo F411RE/Src/Nucleo F411RE/LUMEX_SML-LX0603GW-TR.CATPart
3D/Board/Nucleo F411RE/Src/Nucleo F411RE/LUMEX_SML-LX0603SRW-TR.CATPart
3D/Board/Nucleo F411RE/Src/Nucleo F411RE/LUMEX_SML-LX2835IGC-TR.CATPart
3D/Board/Nucleo F411RE/Src/Nucleo F411RE/MOLEX_0678038020_for_NUCLEO.CATPart
3D/Board/Nucleo F411RE/Src/Nucleo F411RE/MOLEX_90059-0007.CATPart
3D/Board/Nucleo F411RE/Src/Nucleo F411RE/NUCLEO-F411RE.CATProduct
3D/Board/Nucleo F411RE/Src/Nucleo F411RE/NXP_BC847B,215.CATPart
3D/Board/Nucleo F411RE/Src/Nucleo F411RE/YAGEO_CC0603KRX7R7BB104.CATPart
3D/Board/Nucleo F411RE/Src/Nucleo F411RE/YAGEO_CC0805KKX7R7BB225.CATPart
3D/Board/Nucleo F411RE/Src/Nucleo F411RE/YAGEO_RC0603JR-070RL.CATPart
3D/Board/Nucleo F411RE/Src/Nucleo F411RE/_NPart#1012596.CATPart
3D/Board/Nucleo F411RE/Src/Nucleo F411RE/_NPart#1026083.CATPart
3D/Board/Nucleo F411RE/Src/Nucleo F411RE/_NPart#1062043.CATPart
3D/Board/Nucleo F411RE/Src/Nucleo F411RE/_NPart#1126804.CATPart
3D/Board/Nucleo F411RE/Src/Nucleo F411RE/_NPart#1146451.CATPart
3D/Board/Nucleo F411RE/Src/Nucleo F411RE/_NPart#1260879.CATPart
3D/Board/Nucleo F411RE/Src/Nucleo F411RE/_NPart#13162.CATPart
3D/Board/Nucleo F411RE/Src/Nucleo F411RE/_NPart#1355469.CATPart
3D/Board/Nucleo F411RE/Src/Nucleo F411RE/_NPart#138695.CATPart
3D/Board/Nucleo F411RE/Src/Nucleo F411RE/_NPart#1444253.CATPart
3D/Board/Nucleo F411RE/Src/Nucleo F411RE/_NPart#1473582.CATPart
3D/Board/Nucleo F411RE/Src/Nucleo F411RE/_NPart#206104.CATPart
3D/Board/Nucleo F411RE/Src/Nucleo F411RE/_NPart#261706.CATPart
3D/Board/Nucleo F411RE/Src/Nucleo F411RE/_NPart#336422.CATPart
3D/Board/Nucleo F411RE/Src/Nucleo F411RE/_NPart#346240.CATPart
3D/Board/Nucleo F411RE/Src/Nucleo F411RE/_NPart#454641.CATPart
3D/Board/Nucleo F411RE/Src/Nucleo F411RE/_NPart#501589.CATPart
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
