jazari-akuna/lib-elec/(commit log)

2020-06-12 Add Kicad library
2020-06-12 Add 3D library
    [2604-3102.stp, 691413720002B_Download_STP_691413720002B_rev1.stp, 691413720004B_Download_STP_691413720004B_rev1.stp, 768250012.stp, 8040.0001_03.STEP, B02B-PASK-1.stp, B03B-PASK-1.stp, B04B-PASK-1.stp]
2020-06-14 Add Pololu G2 18V25 and some 3D models
    [Pin Header 2.stp, pxc_1757242_06_MSTBA-2-5-2-G-5-08_3D.stp]
2020-08-08 Add Nucleo STM32 F303K8, need to add 3D model
2020-08-15 Add molex AX12 and remove useless file
    [22035035.stp, PTN78020_TH_MM.stp]
2020-11-14 Add Evo Bus connectors
    [690367281076 (rev1).stp, 690367281276 (rev1).stp]
2020-11-15 Update Pololu G2-18v25 model and add Phoenix model
    [Document.1.CATPart, Document.CATPart, ZL262-1S_P2-54_L2-54_W2-54_H8-5.CATPart, ZL262-2D_P2-54_L2-54_W5_H8-5.CATPart, pololu-smc-g2-18v25-or-24v19-with-connectors.CATProduct]
2020-11-15 Add Nucleo F303K8 3D model
    [ABS07-120.CATPart, Extruded.CATPart, Extruded_1.CATPart, Extruded_10.CATPart, Extruded_11.CATPart, Extruded_12.CATPart, Extruded_13.CATPart, Extruded_14.CATPart]
2020-12-25 Add some parts
    [22035035.stp, 450302014072 (rev1) with Header.CATProduct, 450302014072 (rev1) with Header.stp, 450302014072 (rev1).stp, 79578211 (rev1).stp, B5B-XH-A.STEP, B5B-XH-AM.stp, Download_STP_64900429522 (rev1).stp]
2020-12-25 Add PLC4 led
    [PLCC-4-Led.STEP]
2020-12-26 Add smd switch
    [434121050816 (rev1).stp]
2020-12-28 WS-TATL switch footprint, 3D model and symbol
    [44 0xx6 7082 622 (rev1).stp]
2020-12-29 Add some components
    [2.54 mm DUPONT MALE PIN HEADER, IO, 2X20, RPi4ModelB_1.CATPart, 2.54 mm DUPONT MALE PIN HEADER, POE, 2X2, RPi4ModelB_1.CATPart, 2X USB2.0 PORTS, RPi4ModelB_1.CATPart, 2X USB3.0 PORTS, RPi4ModelB_1.CATPart, 40x40x10 DC Fan.STEP, 91D77 D9WHV 778K, 4 GB LPDDR4 SDRAM, RPi4ModelB.CATPart, Broadcom BCM2711B0 CPU, RPi4ModelB.CATPart, Broadcom BCM54213PE Gigabit Ethernet Transceiver, RPi4ModelB.CATPart]
2020-12-30 relative path in switch 3D model
2020-12-31 Update connectors
    [649004227222 (rev1).stp, 66200621022 (rev1).stp]
2021-01-02 Add 66200221022
    [66200221022 (rev1).stp]
2021-01-04 Vertical power connectors
    [66200221122 (rev1).stp, 66200621122 (rev1).stp]
2021-01-05 Fixed power connectors 3D model
2021-01-24 Add Power Mosfet
    [SI7994DP-T1-GE3.STEP]
2021-01-24 Add template for schematic cartridge
2021-01-25 20mm FAN
    [DC_Fan_20x20x10.stp]
2021-03-30 Add some components, clean others
    [649002113322 (rev1).stp, 66200421022 (rev1).stp, 66200421122 (rev1).stp, Download_STP_WL-SBTW-3528 (rev1).stp, LTC4353IMS#PBF.STEP]
2021-05-03 Nappe connectors
    [686115183422 (rev1).stp, 686115183522 (rev1).stp]
2021-08-03 Update lib with too old components to remember
    [c-292303-1-e4-3d.stp]
2021-08-05 Order and clean 3D directory
    [22035035.stp, 2604-3102.stp, 40x40x10 DC Fan.STEP, 434121050816 (rev1).stp, 44 0xx6 7082 622 (rev1).stp, 450302014072 (rev1) with Header.CATProduct, 450302014072 (rev1) with Header.stp, 450302014072 (rev1).stp]
2021-08-06 Add 691406710002B connector
    [691406710002B (rev1).stp, Download_STP_64900429522 (rev1).stp]
2021-08-13 Add traco converters
    [TDN_5-2410WI.step, TEN_60-2412WIN.step, THL_25-2412WI.step]
2021-08-15 Add new connectors and components
    [22057035.stp, 450302014072 (rev1).stp, 9774100360 (rev1).stp, ESQ-120-24-T-D.stp]
2021-08-15 Rework board lib
    [2.54 mm DUPONT MALE PIN HEADER, IO, 2X20, RPi4ModelB_1.CATPart, 2.54 mm DUPONT MALE PIN HEADER, POE, 2X2, RPi4ModelB_1.CATPart, 2X USB2.0 PORTS, RPi4ModelB_1.CATPart, 2X USB3.0 PORTS, RPi4ModelB_1.CATPart, 61304021821 (rev1).stp, 61304021821.CATProduct, 6130xx21821_PIN.CATPart, 91D77 D9WHV 778K, 4 GB LPDDR4 SDRAM, RPi4ModelB.CATPart]
2021-10-21 Add D0214AB footprint and LTC2952 symbol
    [DO-214AB.STEP]
2021-10-23 Add some connectors
    [681M7W2103L001.stp, 684M7W2103L461.STEP, JST - XH - Thru V - 5Pin - 2.54mm.stp]
2021-11-08 Add some connectors / components
    [684M7W2103L461.STEP, 684M7W2103L461.stp, SN74LVC2G02DCUR.STEP]
2021-11-14 Add a reversed version of Pololu G2-18V25
    [pololu-smc-g2-18v25-or-24v19-with-connector-reversed.CATProduct]
2021-11-29 Add Nucleo F303RE
    [38-Pin Header - Female - Double - 2.54mm.CATProduct, 38-Pin Header - Female - Double - 2.54mm.step, 38-Pin-Header-Female-Double-2.54mm_1.CATPart, 61300421821 (rev1).CATProduct, 61300421821 (rev1).stp, 61300421821.CATPart, 61304021821 (rev1).CATProduct, 61304021821 (rev1).stp]
2022-04-03 Some minor updates
    [022035045.stp]
2022-04-12 Add MP1584EN and RX28 connector
    [61300211121.CATPart, 61300211821 (rev1).CATProduct, 61300211821 (rev1).stp, 61300211821.CATPart, 6130xx11121_PIN.CATPart, 6130xx11821_PIN.CATPart, D-SUN dc-dc step down converter.CATProduct, Download_STP_61300211121 (rev1).CATProduct]
2022-04-12 Add Arduino Nano footprint
    [Arduino NanoV3 + Female Headers.step]
2022-05-01 Add 690367181072
    [690367181072.stp]
2022-06-15 Add Raspberry Pi Zero W footprint
    [61304021821 (rev1).CATProduct, 61304021821 (rev1).stp, 61304021821.CATPart, 6130xx21821_PIN.CATPart, 970110155.CATPart, Board.CATPart, CAPC-0402-T0.55-BN.CATPart, CAPC-0603-T0.9-BN.CATPart]
2022-06-21 Update connectors lib
    [S03B-PASK-2.stp, User Library-xt30upb-m.STEP]
2022-06-21 Add new fuse holder and fix some components type
    [0031-7701-11.STEP]
2022-06-21 Fix Raspberry Pi Zero
2022-06-21 Add MPRLS component
    [MPRLS0025PA00001A.step]
2022-09-26 Add tactile switch
2022-09-26 Add LDR-Pedestal footprint
2022-09-26 Move LDR Pedestal 3D model to library
    [LDR Pedestal.stp]
2022-11-11 Add banana Staubli connectors
    [Banana Plug 4mm Black CT2238 v1.stp, Banana Plug 4mm Red CT2238 v1.step]
2022-11-27 Add components for the controleur moteur board
    [FTSH-107-01-L-DV-K.step, sc705_model.STEP]
2022-12-03 Add some components for evo motor controller board
2022-12-05 Add components for evo-motor-controller board
    [434121043836 (rev1).stp, Download_STP_830030819 (rev1).stp, POWERSSO-36TP_STM.step, STP_629722000214 (rev1).stp]
2023-01-10 Fix footprints types and add some components for evo-motor-controller
    [Download_STP_65100516121 (rev1).stp, LDR Pedestal.stp]
2023-03-01 Add M2 spacer
    [9774010243 (rev1).stp]
2023-04-03 Migrate symbol libraries to Kicad 6
2023-04-03 Wip ESC
2023-04-03 Add 3D models of ESC
    [61300411121.CATPart, 61300511121.CATPart, 61300611121.3.CATPart, 61300611121.CATPart, 6130xx11121.1.CATProduct, 6130xx11121_PIN.2.CATPart, 6130xx11121_PIN.CATPart, CtrlBL_Emax_Bullet_15A_light.CATPart]
2023-04-03 Add infos on ESC footprint silkscreens
2023-04-03 Clean SC70-5 footprint
2023-04-03 Add Fan symbols and update Raspberry Pi with 11mm headers
2023-04-03 Fix ESC symbols
    [66200221122 (rev1).stp]
2023-04-03 Add MCP3 and MCP4 connectors
    [64900311122 (rev1).stp]
2023-04-03 Fix F303 footprint and add 9774160360
    [9774100360 (rev1).stp, STP_9774160360 (rev1).stp]
2023-04-03 Add Littlefuse socket
    [User Library-01530007Z.step]
2023-04-03 Add evo motor controller
2023-04-28 Add GC9A01
    [61300811121 (rev1).CATProduct, 61300811121 (rev1).stp, 61300811121.CATPart, 61300815721 (rev1).CATProduct, 61300815721 (rev1).stp, 61300815721.CATPart, 6130xx11121_PIN.CATPart, 6130xx15721_PIN.CATPart]
2023-04-28 Add USB C PDC
    [PDC004-PD v4.step]
2023-08-05 Add 3557-2 fuse holder
    [3557-2.step]
2023-08-05 Add WSEN-PDUS 6 pin connector
    [690367280676 (rev1).stp, WSEN-PDUS_rev1.stp]
2023-08-05 Add 2 pin 3.5mm header + WSEN-PDUS pressure sensor
    [691321100002 (rev1).stp, wsen-pdus_STP_2513130810001 (rev1).stp]
2023-08-05 Ad 4 and 8 pin WR-MM, move connector in wrong (component) lib
    [690367280476 (rev1).stp, 690367280876 (rev1).stp]
2023-08-05 Add Pogo connectors 19 pins
2023-08-05 Add 3D models of Pogo connectors
    [Pogo connector 19 pins female.CATPart, Pogo connector 19 pins female.stp, Pogo connector 19 pins male.CATPart, Pogo connector 19 pins male.stp]
2023-08-05 Update 3D model orientation for Pogo connector
2023-08-05 Add WR-MM male SMD 10
    [690357281076 (rev1).stp]
2023-08-05 Add 450301014042 and correct 450301014072
    [450301014042 (rev1).stp]
2023-09-01 Add 452403012014
    [Download_STP_452403012014 (rev1).stp]
2023-09-02 Add 452404020202
    [Download_STP_452404020202 (rev1).stp]
2023-09-03 Create PAD footprint
2023-09-20 Add two FPC connectors from Amphenol
    [SFW15R-1STE1LF.step, SFW15R-2STE1LF.step]
2023-09-21 added 3D files for the ADNS 9800
    [ADNS_9800_Lentille.stp]
2023-09-23 Add new footprints for the Pedestal
    [Buzzer 9x5.5mm.CATPart, Buzzer 9x5.stp, Pad Silicone 6x2mm.CATPart, Pad Silicone 6x2mm.stp]
2023-10-04 Add a more easy to sold rgb led anf fix logo for solder mask
2023-10-05 Update footprint for WR-MM
2023-10-05 Add TSR 2-2450
    [tsr2_3d_drawing.stp]
2023-10-14 Add Adafruit BNO085
    [61300611121.CATPart, 61300611821 (rev1).CATProduct, 61300611821.CATPart, 6130xx11121_PIN.CATPart, 6130xx11821_PIN.CATPart, 9774015243R (rev1).stp, Adafruit BNO085 STEMMA QT.step, Adafruit BNO085.CATProduct]
2023-10-15 Add USB C 6 pins and DOME Led / fix some footprints
    [Download_STP_WL-SMTW_3528_Dome-30 (rev1).stp, USB4125-GF-A_REVA2.step]
2023-10-22 Fix TSR 2-2450 footprint
2023-10-22 Add 66200211022
    [66200211022 (rev1).stp]
2023-10-31 initial work on adding the power selector for ACDC
2023-11-01 Add 9774110360
    [9774110360R (rev1).stp]
2023-11-02 Add 9774100360 part and RS SPDT
    [9774100360R (rev1).stp, Power Switch RS SPDT.CATPart, Power Switch RS SPDT.stp]
2023-11-03 added 9th pin on TB67H451FNG
2023-11-06 added 3D for the BNO08x
    [BNO08x.step]
2023-11-06 fixed incorrect RST pin on the BNO085
2023-11-12 Create Pimoroni PAA5100JE.kicad_mod
2023-11-16 Cleaned up the PAA5100JE footprint
2023-11-17 Add MCP5 connectors
    [STP_MPC5_657002140101 (rev1).stp, STP_MPC5_657003140101 (rev1).stp]
2023-12-18 Add WL-SBCW_1210
    [Download_STP_WL-SBCW-1210 (rev1).stp]
2023-12-19 Add 651005136421
    [651005136421 (rev1).stp]
2023-12-30 Add 435431019840
    [STP_435431019840 (rev1).stp]
2024-01-07 added f mask to the 5V and GND pads
2024-01-22 fixed the edge cut being on the footprint for some reason
2024-01-22 added 3D files
    [GCT_USB4140-GF-0170-C_REV0.4.stp]
2024-01-22 Add 9774030360 and fix other spacers
    [9774030360R (rev1).stp]
2024-03-05 Add Raspberry Pi Zero W vertical and 74663025
    [613040243121.CATPart, 6130xx243121_PIN.CATPart, 6130xx243121_PIN_G.CATPart, 74663025R.CATPart, Downloads_STEP_613040243121 (rev1).CATProduct, Entretoise3D.CATPart, Raspberry PI Zero W Vertical.CATProduct, STP_74663025 (rev1).stp]
2024-03-06 Add 649006227222
    [649006227222 (rev1).stp]
2024-03-06 Fix STP file artefact
    [Entretoise3D.CATPart, Raspberry PI Zero W Vertical.CATProduct]
2024-03-10 Fix connectors
2024-03-14 Add 430456085736
    [430456085736 (rev1).stp]
2024-03-15 Add Nucleo 32 SMD
    [61001613321 (rev1).CATProduct, 61001613321 (rev1).stp, 6100161xx21.CATPart, 6100xx1xx21_PIN.CATPart, Extruded_32.CATPart, MB1180 - SMD.CATProduct, MB1180 - SMD.stp]
2024-03-17 Ajout du symbole WireSolder_Pad
2024-03-18 Ajout STEP Rpi zero sans header et avec carte SD
    et ajout du paramètre d'exclusion de la BOM du SolderPad
    [microsd-card.stp]
2024-03-20 fixed 1.13 on the smd nucleo footprint
2024-03-20 switched type to smd (for proper 3D view)
2024-03-22 Fix pin numbers
2024-03-27 Add NodeMCU Esp32
    [BUTTONFLASH-13_2.CATPart, BUTTONFLASH-14_2.CATPart, MICROCHIP_2.CATPart, NodeMCU Esp32.CATProduct, NodeMCU Esp32.stp, PCB.CATPart, PIN.CATPart, RECTANGULARCHIP_2.CATPart]
2024-03-29 Add 66200221124 and fix 649006227222 footprint type
    [66200221124_STP (rev1).stp]
2024-05-23 added STM32F4XX M
2024-05-23 added Adafruit BMP390
    [Adafruit BMP390 QT.stp]
2024-05-23 added the adafruit SD breakout
    [Adafruit SD breakout.stp]
2024-05-30 added SWDIO to the STM32F4
2024-05-31 minor tweaks to the previously mentionned footprints
2024-06-01 low profile SD and STM32 - awaiting 3Ds
2024-06-01 made a pin socket for it
    warning : needs proper verification of the actual model of pin socket we are using, as the 3d model for the BNO085 has a different height due to the pin socket being taller
    [Adafruit BMP390 QT.stp]
2024-06-13 added 3D to the 22 05 7025
    [22057025.stp]
2024-06-15 Update STM32F4XX M 3D model
    [61300411121.CATPart, 61300411821 (rev1).CATProduct, 61300411821.CATPart, 61304421121.CATPart, 61304421821 (rev1).CATProduct, 61304421821.CATPart, 6130xx11121_PIN.2.CATPart, 6130xx11821_PIN.CATPart]
2024-06-15 Update Adafruit BMP390 footprint
    [10K.CATPart, 10K_1.CATPart, 10uF.CATPart, 1N4148.CATPart, 61300811821 (rev1).CATProduct, 61300811821.CATPart, 6130xx11821_PIN.CATPart, 9774085151.CATPart]
2024-06-15 Clean BNO085 Src files
    [61300611121.CATPart, 61300611821 (rev1).CATProduct, 61300611821.CATPart, 6130xx11121_PIN.CATPart, 6130xx11821_PIN.CATPart, Adafruit BNO085 STEMMA QT.step, Adafruit BNO085.CATProduct, BNO085-9axis-IMU.CATPart]
2024-06-15 fixed BMP390's mounting pads
2024-06-15 Add Adafruit BNO085 3D model with SMD Spacers
    [9774085151.CATPart, Adafruit BNO085 with SMD Spacers.CATProduct, Adafruit BNO085 with SMD Spacers.stp]
2024-06-15 Add Adafruit SD Breakout 3D model
    [0.1uF.CATPart, 10uF.3.CATPart, 47K.CATPart, 61300911821 (rev1).CATProduct, 61300911821.CATPart, 6130xx11821_PIN.CATPart, 970120151.CATPart, Adafruit SD Breakout.CATProduct]
2024-08-16 Add WIO-E5 module
    [317990829--3DModel-STEP-269445.STEP]
2024-08-18 Add 62701420621
    [Download_STP_62701420621_rev1.stp]
2024-08-18 Add 636101111001
    [RSP-122811-01--3DModel-STEP-56544.STEP]
2024-08-19 Minor improvements
    Added VIN marking to the BNO085
    Modified the BMP's symbol to make it easier to integrate in a schematic
    re-centered other symbols
2024-09-26 started working on paa5163
    optical center need to be added to the footprint
2024-10-21 Add 1313210530000
    [STP_WL-ICLED_1313210530000 (rev1).stp]
2024-10-24 minor fix to PAA5163E1 and BNO085
    added do not connect symbols to unused pins to satisfy the PCB updater
2024-10-29 Add 648105131822
    [648105131822 (rev1).stp]
2024-10-29 Add 693071020811
    [Download_STEP_693071020811 (rev1).stp]
2024-11-03 Add 435441019830
    [Download_435441019830_STP (rev1).stp]
2024-11-05 added 3D
    [PAA5160E1-Q-16L-6x6-LGA.CATPart, PAA5160E1-Q-16L-6x6-LGA.stp]
2024-11-14 Fix 693071020811 footprint and STM32G491KEUx symbol/footprint
2024-11-16 added pin 1 indicator back
2025-01-02 Add BN085 3D Model
    [BNO085.stp]
2025-01-11 Add 1642730961200
    [Downloads_STP_WL-OSEN_1642730961200 (rev1).stp]
2025-01-11 Add 686108188622
    [Download_STP_686108188622 (rev1).stp]
2025-01-11 Add MCP4 footprints with larger pads
2025-01-11 Add 830009678 3D model
    [Download_STP_830009678 (rev1).stp]
2025-02-28 Add Low Profile Mechanical switch and SN74LVC2G74DCUR
    [Download_STEP_150302xx73100 (rev1).stp, KS33-low profile switch and stabilzier.stp]
