jazari-akuna/lib-elec/(notices)

Notices in the files:
3D/Board/Nucleo F303K8/Src/SSQ-115-01-G-S.stp:
FILE_NAME( 'p:/temp/worker_114/temp/exporttempdir_3828_766_BqSe3/format_0/SSQ-115-01-G-S.stp', '2020-11-15T20:31:00', ( 'License CC BY-ND 4.0' ), ( 'CADENAS' ), ' ', 'PARTsolutions', ' ' );
3D/Connectors/FTSH-107-01-L-DV-K.step:
author */ ('License CC BY-ND 4.0'),
